xx0x/gbpxl/schematic-bom-pcb/gbpxl-bom.ods

gbpxl v1.0 BOM, github.com/xx0x/gbpxl
ID | Name | Designator | Footprint | Quantity | Manufacturer Part | Manufacturer | Supplier | Supplier Part
1 | TPS5430DDAR | U2 | SOIC-8_L5.0-W4.0-P1.27-LS6.0-BL-EP | 1 | TPS5430DDAR | TEXAS INSTRUMENTS | TME | TPS5430DDAR
2 | B340A | D1 | SMA_L4.3-W2.6-LS5.2-FD | 1 | B340A | MDD | LCSC | C64982
3 | 220u | C5 | CAP-D8XF2.3_CUT | 1 | A750EK227M1AAAE018 | KEMET | TME | A750EK227M1AAAE018
4 | 22uH | L1 | IND-707040 | 1 | CDRH74-220(F) | ML | LCSC | C133406
5 | 10k | R1 | 0805' | 1
6 | 3.24k | R2 | 0805' | 1
7 | 300 | R3 | 0805' | 1
8 | DSUB25 | COM1 | DSUB25_DOUBLE_SIDED | 1 | DB25-SP | ENCITECH | TME | DB25-SP
9 | 470n | C6,C7,C8,C10,C9 | 0805' | 5
10 | 100n | C1 | 0805' | 1
11 | 4.7u | C3,C2 | 0805' | 2
12 | 10n | C4 | 0805' | 1
13 | DIP SWITCH | SW1 | DIP SWITCHEI-04 | 1 | NDI-04H-V | DIPTRONICS | TME | EAH104E
14 | LED-3MM | LED1 | LED-3MM/2.54 | 1 | FYL-3014LRD1A | FORYARD | TME | FYL-3014LRD1A
15 | MAX232ECSE+ | U3 | SOIC-16_L9.9-W3.9-P1.27-LS6.0-BL | 1 | MAX232ECSE+ | Maxim Integrated | TME | MAX232ECSE+
16 | ATMEGA4809 | U1 | TQFP-48_L7.0-W7.0-P0.50-LS9.0-BL | 1 | ATMEGA4809-AFR | MICROCHIP TECHNOLOGY | TME | ATMEGA4809-AFR
17 | CASE |  |  |  | 2360-0102-23 | ENCITECH | TME | CCOV25-SCL-BK
