xx0x/gbpxl/build-instructions/BUILD_INSTRUCTIONS.md

# gbpxl build instructions

The kit contains quite small components, but it's not THAT difficult to solder it. If you haven't soldered SMD stuff before, I would recommend watching some videos how to to that (eg. https://www.youtube.com/watch?v=f9fbqks3BS8). The PCB surface may differ from pictures (HASL/ENIG), based on the current PCB order.

Also, download the [schematic](https://github.com/xx0x/gbpxl/raw/master/schematic-bom-pcb/gbpxl-schematic.pdf) at first.

*Disclaimer: I'm a self-taught hobbyist, not a "professional" so if you have better tools or practices, use them as you wish.*

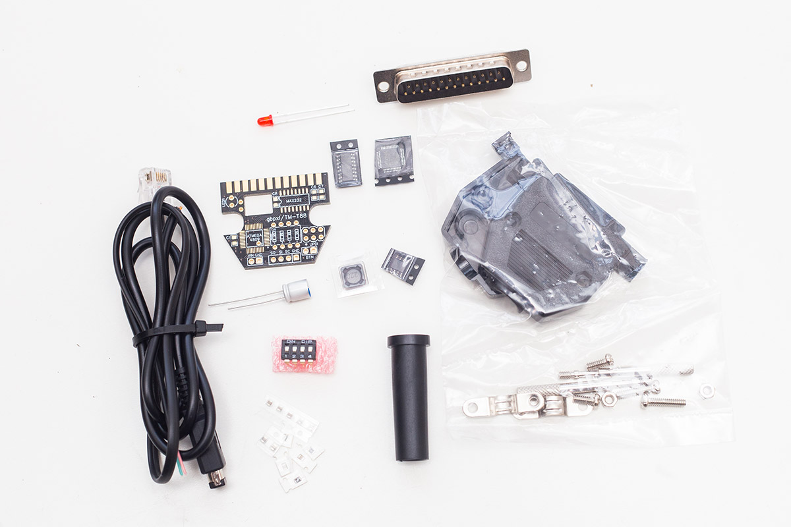
[picture p5: build-instructions/img/gbpxl-build-001.jpg]


## The kit contains

| PCB Designator  | Part name |
|---|---|
| U1 | ATMEGA4809 microcontroller (pre-programmed) |
| U2 | TPS5430DDAR	buck regulator |
| U3 | MAX232 RS232 transceiver |
| R1 | 10k SMD 0805 resistor |
| R2 | 3.24k SMD 0805 resistor	 |
| R3 | 300 SMD 0805 resistor |
| C1 | 100n SMD 0805 capacitor |
| C2,C3 | 4.7u SMD 0805 capacitor |
| C4 | 10n SMD 0805 capacitor |
| C5 | 220u THT capacitor |
| C6,C7,C8,C9,C10 | 470n SMD 0805 capacitors |
| D1 | B340A diode |
| L1 | 22uH power inductor	 |
| SW1 | 4 position DIP SWITCH |
| LED1 | 3mm red LED |
| COM1 | DSUB25 male connector |
| - | Connector case + screws |
| - | RJ12 power cable (approx 20 cm) |
| - | Game Boy link cable (smaller connector type, approx 55 cm) |
| - | Cable strain relief |

The kit contains link cable for newer Game Boys (Pocket, Color), since the cables for the original Game Boy are quite hard to get (= expensive). If you want to use it with the original GB, get yourself an adapter as you can see in the video.

## 1. Step: Soldering the components

First, start with the buck regulator. Tin the large pad and one IC pad.

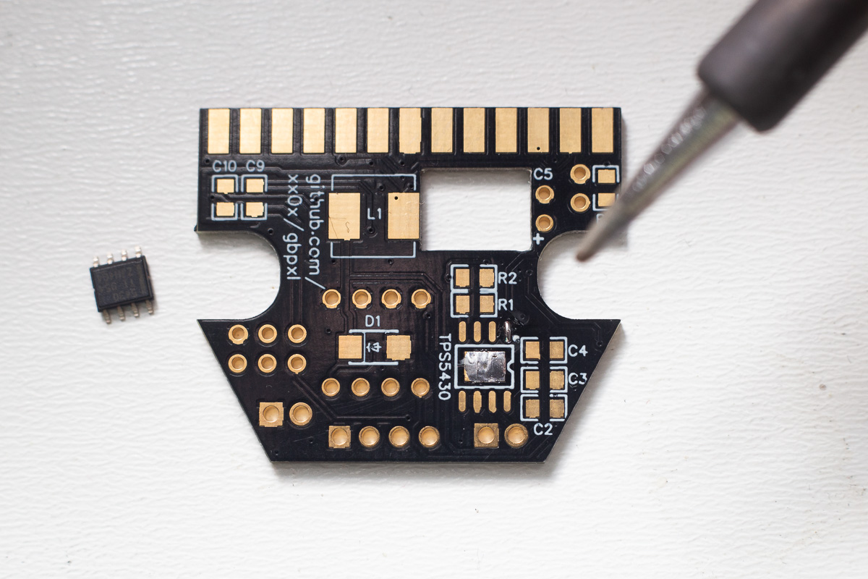
[picture p6: build-instructions/img/gbpxl-build-002.jpg]

  
&nbsp;

Then, solder the first IC pin.

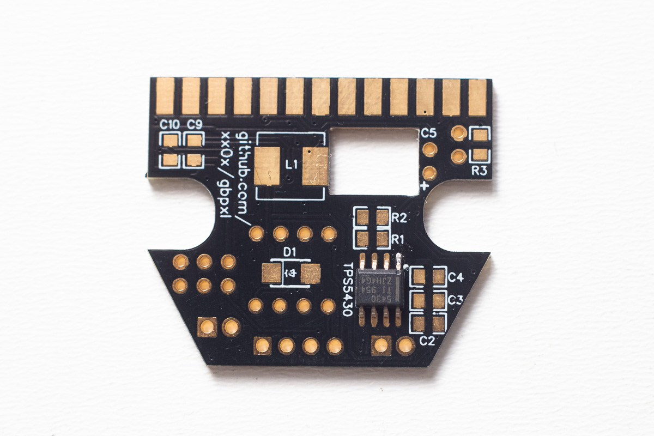
[picture p7: build-instructions/img/gbpxl-build-003.jpg]


&nbsp;

Turn the PCB upside down, and reheat the large pad using the hole to melt the solder under the chip - while putting a little bit of pressure on the board for the IC to make good contact.

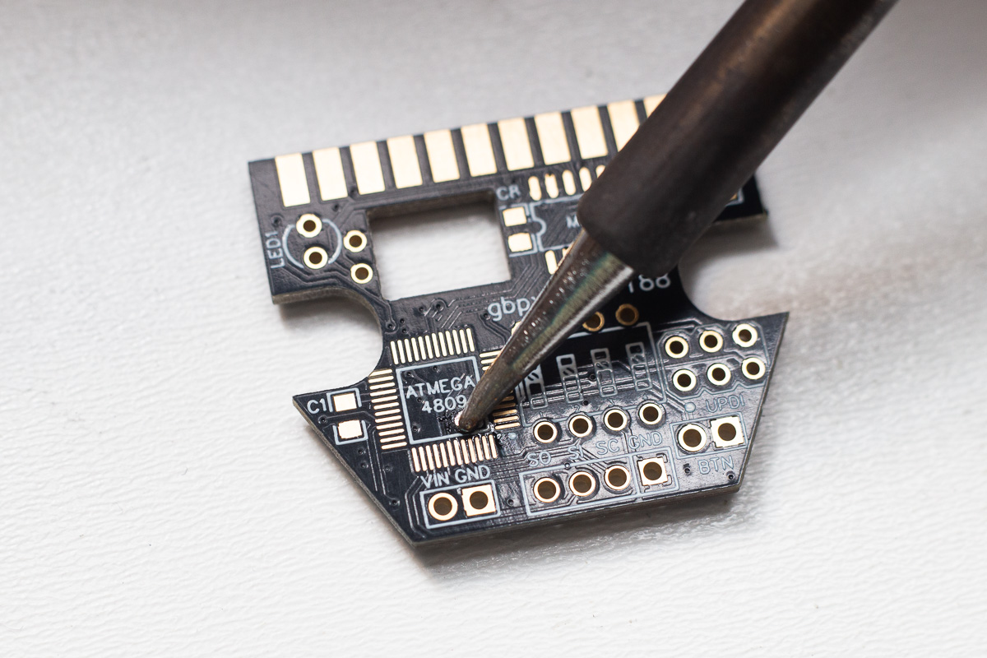
[picture p8: build-instructions/img/gbpxl-build-004.jpg]


&nbsp;

Finish soldering the buck regulator, and remember, FLUX is your best friend!

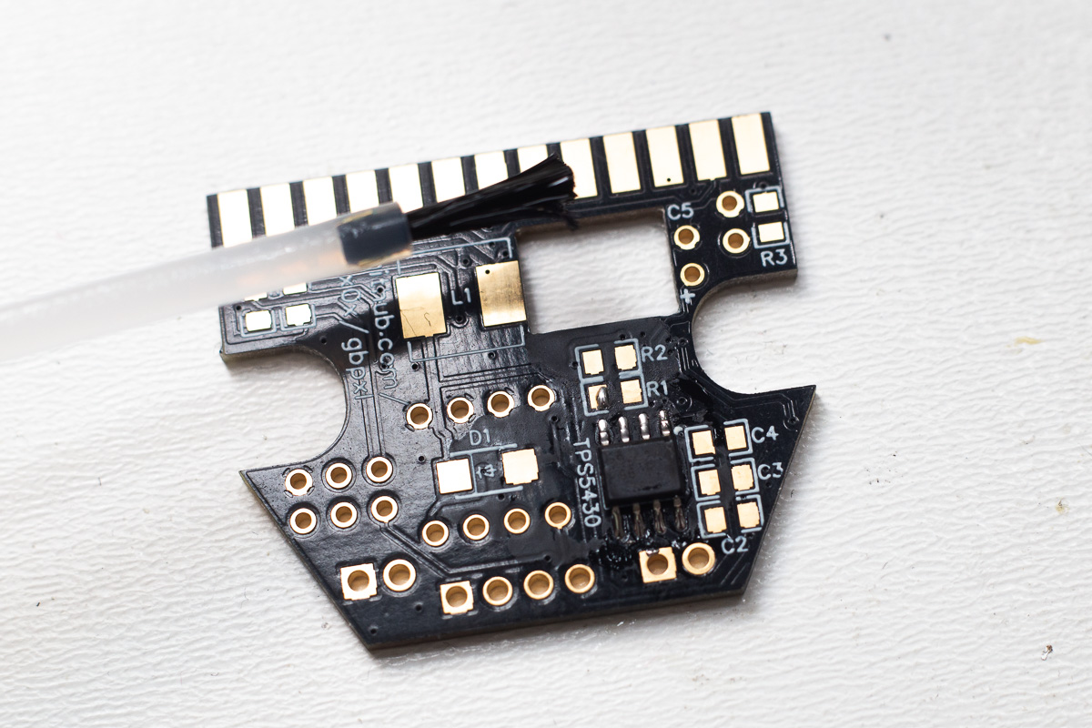
[picture p9: build-instructions/img/gbpxl-build-005.jpg]


&nbsp;

Tin one or two pads for the ATmega. Then, while reheating the pad, push the MCU into it with your tweezers.

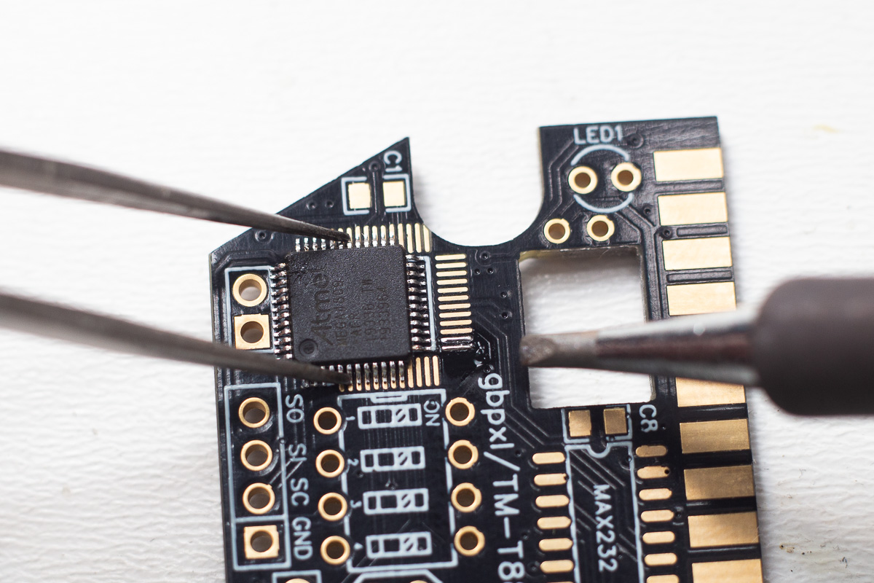
[picture p10: build-instructions/img/gbpxl-build-006.jpg]


&nbsp;

Solder the oposite legs.

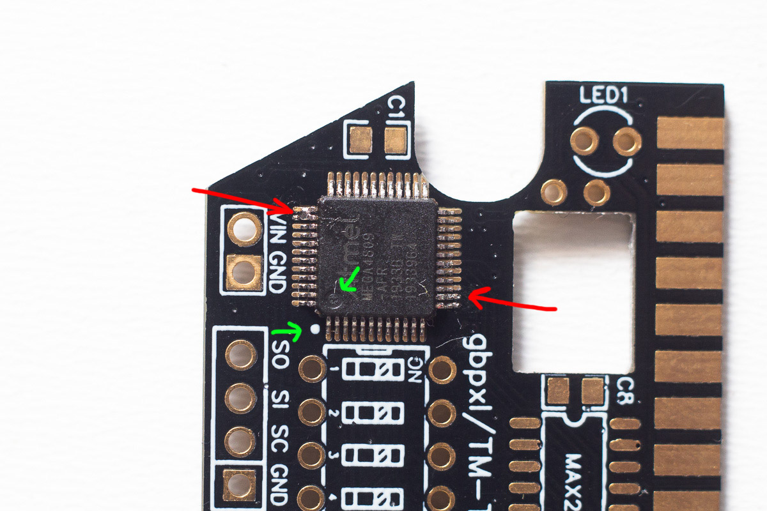
[picture p11: build-instructions/img/gbpxl-build-007.jpg]


&nbsp;

Then, make sure everything's how it's supposed to be and solder the rest. If you end up with solder bridges, you can use solder wick for sucking the excess solder.

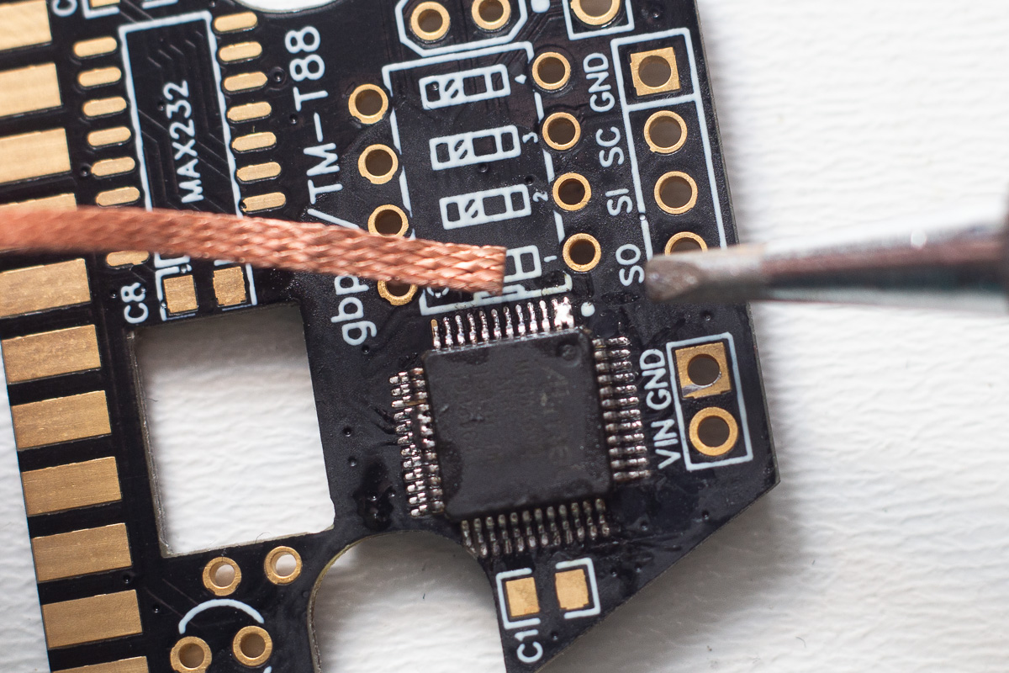
[picture p12: build-instructions/img/gbpxl-build-008.jpg]


&nbsp;

You should end up with something like this.

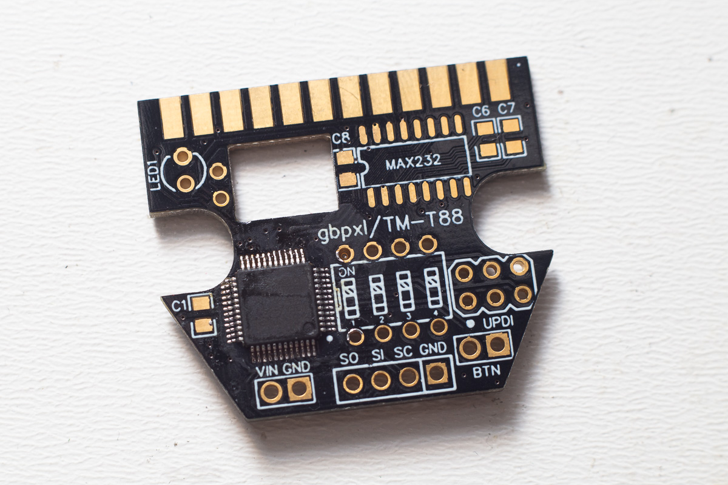
[picture p13: build-instructions/img/gbpxl-build-009.jpg]


&nbsp;

Next, solder the 0805 capacitors and resistors. Resistors are easier, since they have their value written on them. I've manually marked 10nF and 100nF capacitors since they look almost identical and there is one piece of each.

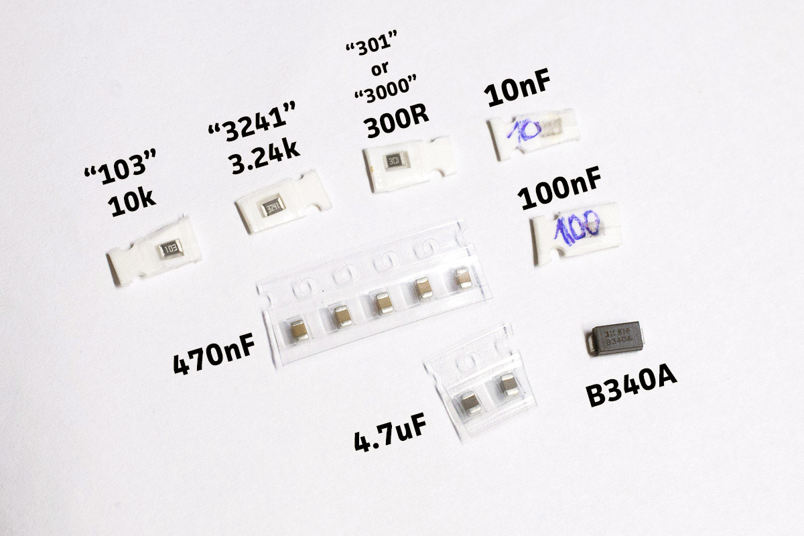
[picture p14: build-instructions/img/gbpxl-build-010.jpg]


&nbsp;

You can use exacto knife for separating the protective layer.

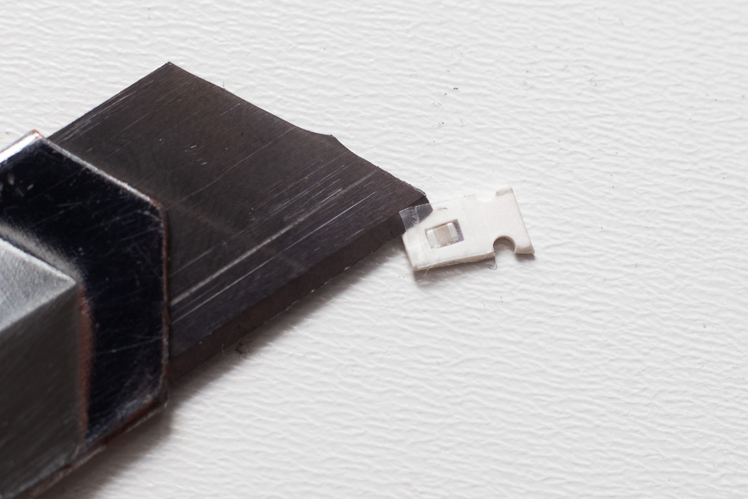
[picture p15: build-instructions/img/gbpxl-build-011.jpg]


&nbsp;

Again, tin one pad and then drag the component into the solder while reheating it. The polarity isn't important when soldering this capacitor.

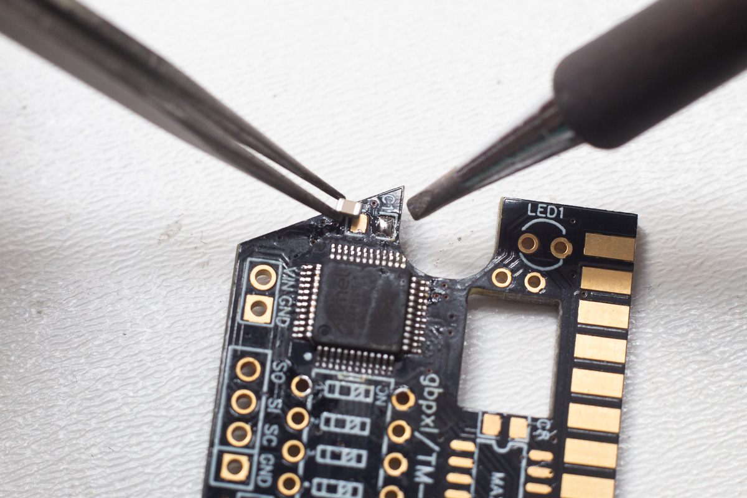
[picture p16: build-instructions/img/gbpxl-build-012.jpg]


&nbsp;

Then, solder the opposite side.

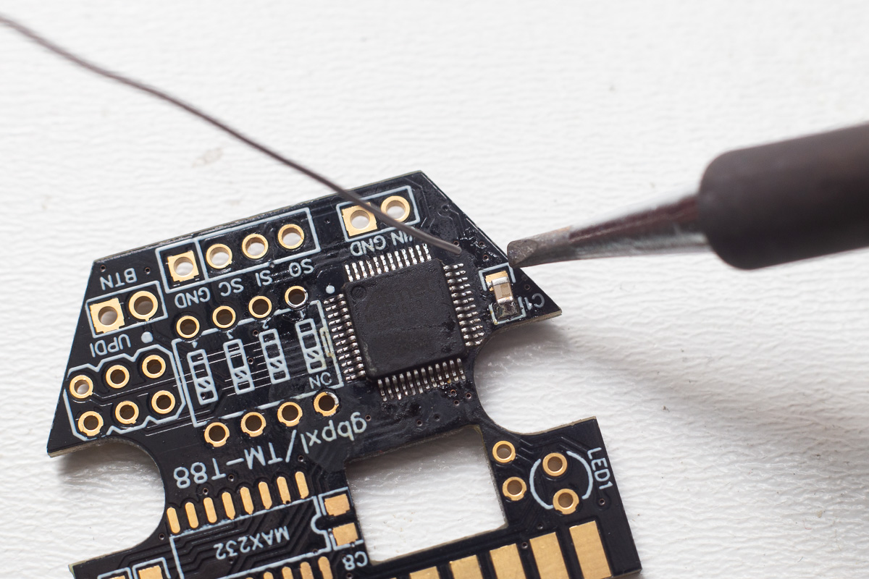
[picture p17: build-instructions/img/gbpxl-build-013.jpg]


&nbsp;

I usually pre-tin pads for all components at once.

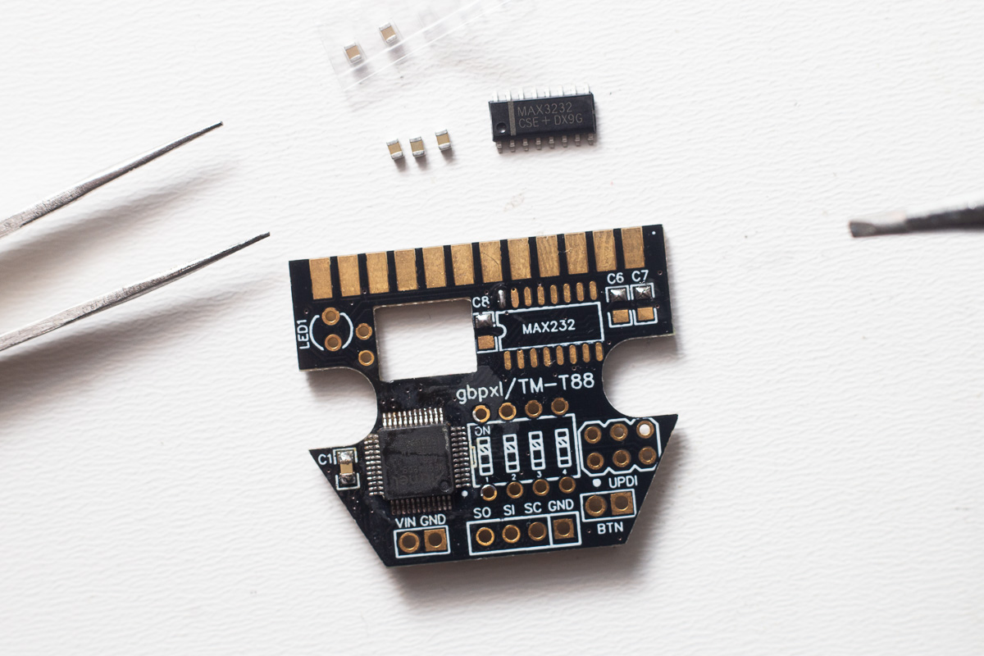
[picture p18: build-instructions/img/gbpxl-build-014.jpg]


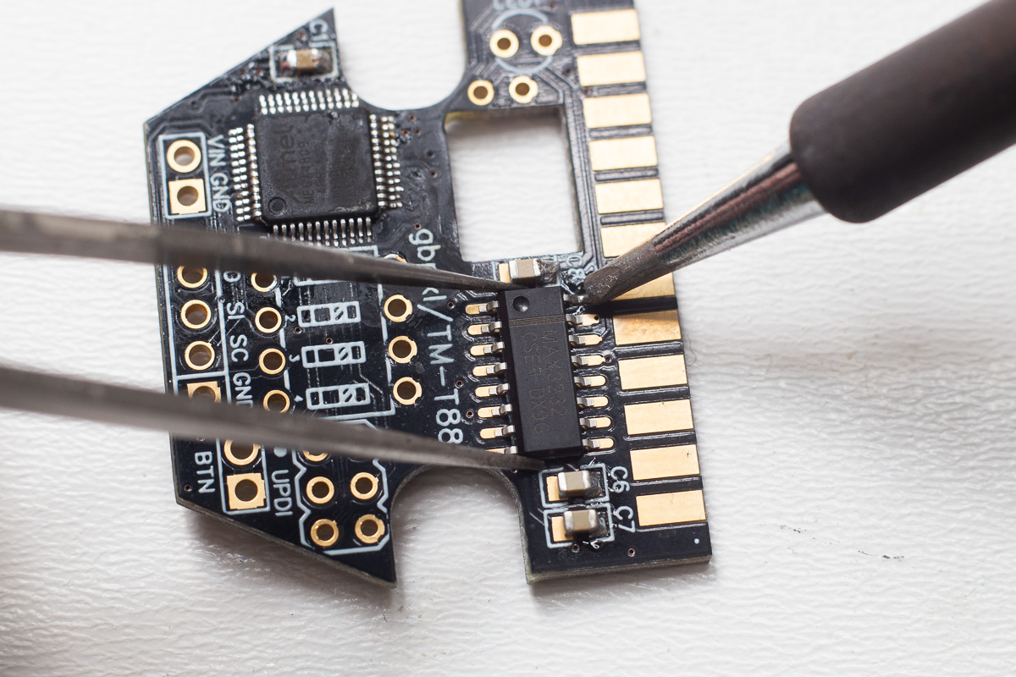
[picture p19: build-instructions/img/gbpxl-build-015.jpg]


&nbsp;

The result should look like this.

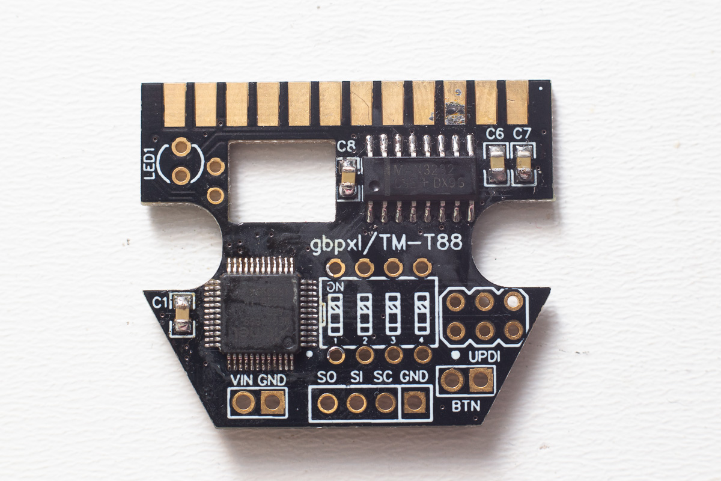
[picture p20: build-instructions/img/gbpxl-build-016.jpg]


&nbsp;

Now let's continue with the bottom side. Watch out - the diode is polarized (the strip on the diode must match the strip on the PCB).

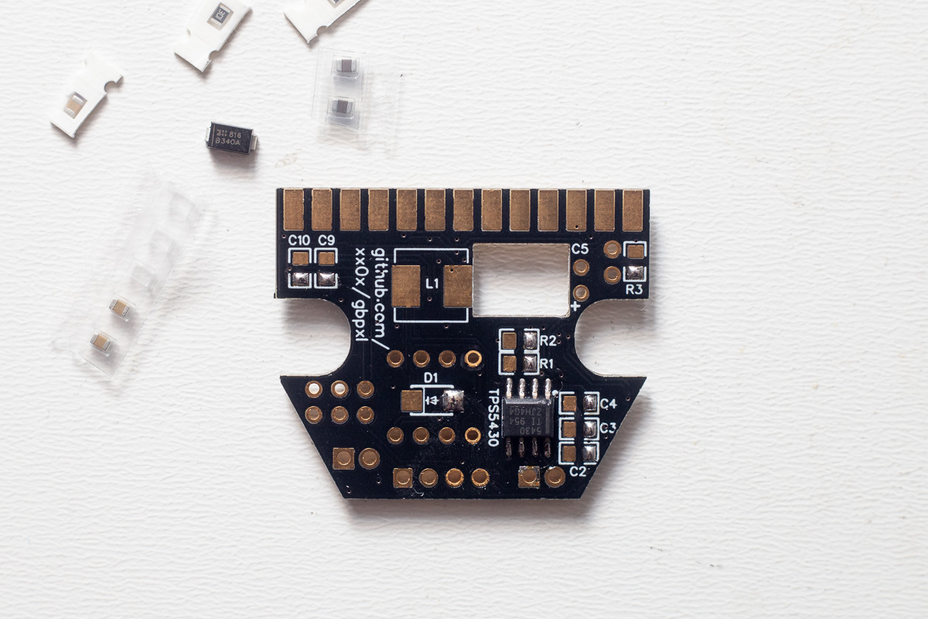
[picture p21: build-instructions/img/gbpxl-build-017.jpg]


&nbsp;

Then, prepare the pads for the inductor. I usually tin both pads, one with more solder.

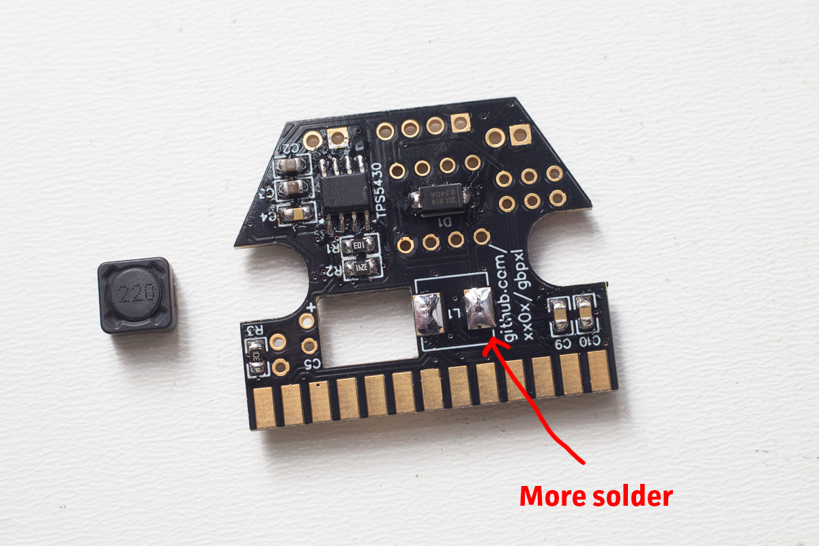
[picture p22: build-instructions/img/gbpxl-build-018.jpg]


&nbsp;

Then drag the inductor into the solder while reheating the pad with more solder.

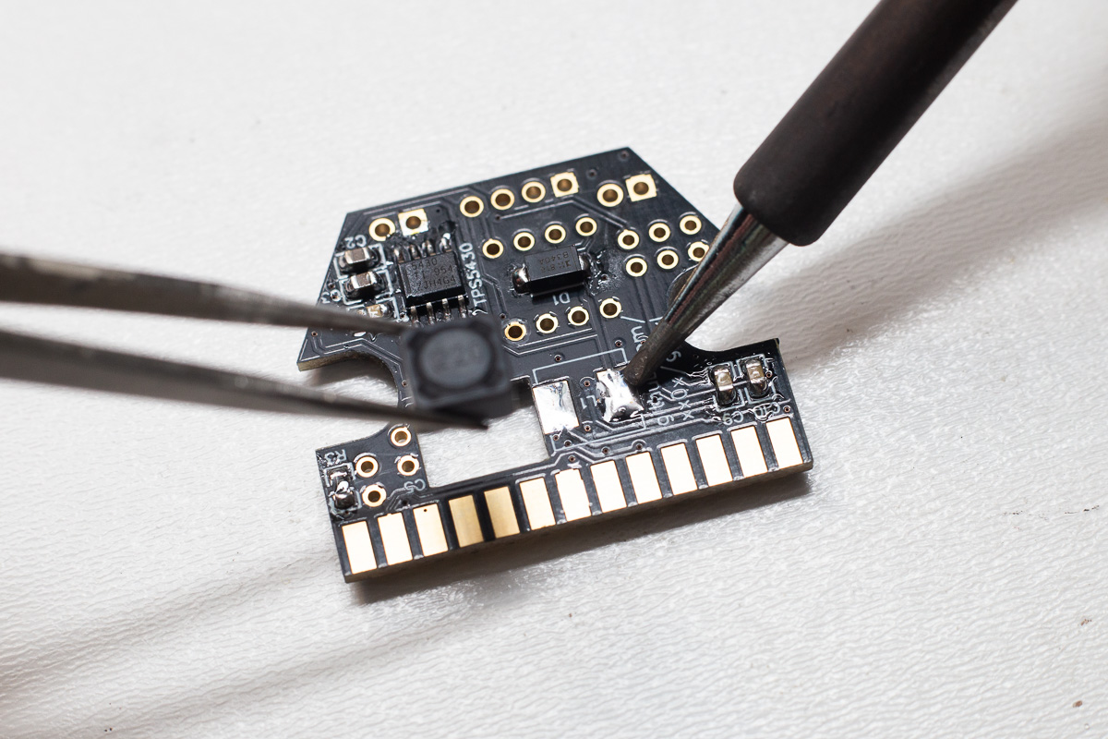
[picture p23: build-instructions/img/gbpxl-build-019.jpg]


&nbsp;

Then finish it by reheating the other pad from the side - adding little bit of solder helps!

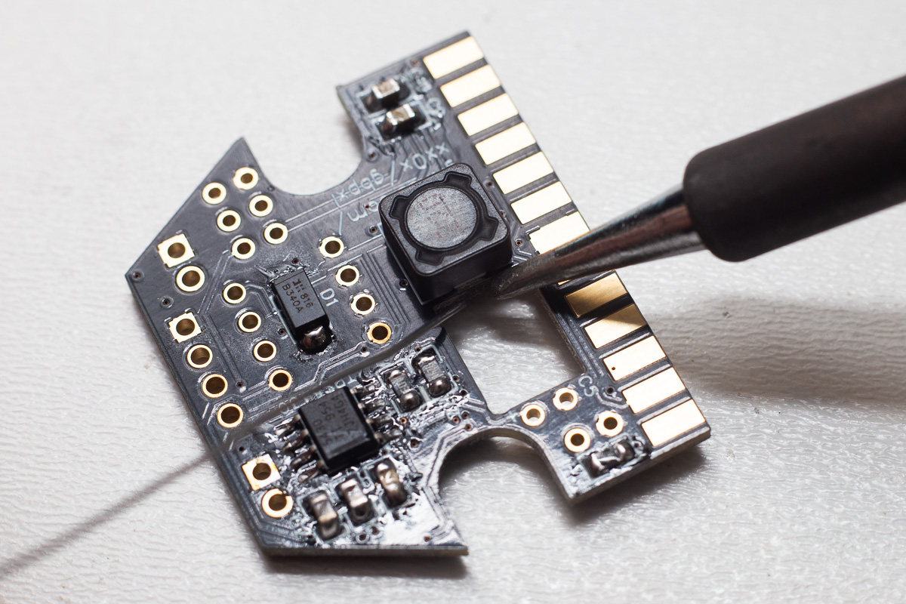
[picture p24: build-instructions/img/gbpxl-build-020.jpg]


&nbsp;

Next comes the big capacitor - which has to be mounted sideways because of the clearance. The longer leg is the positive contact.

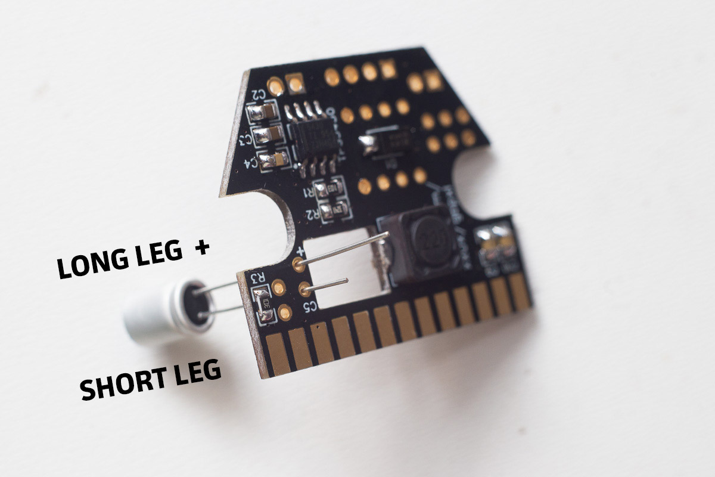
[picture p25: build-instructions/img/gbpxl-build-021.jpg]


&nbsp;

Bend the capacitor inside the PCB hole and solder it.

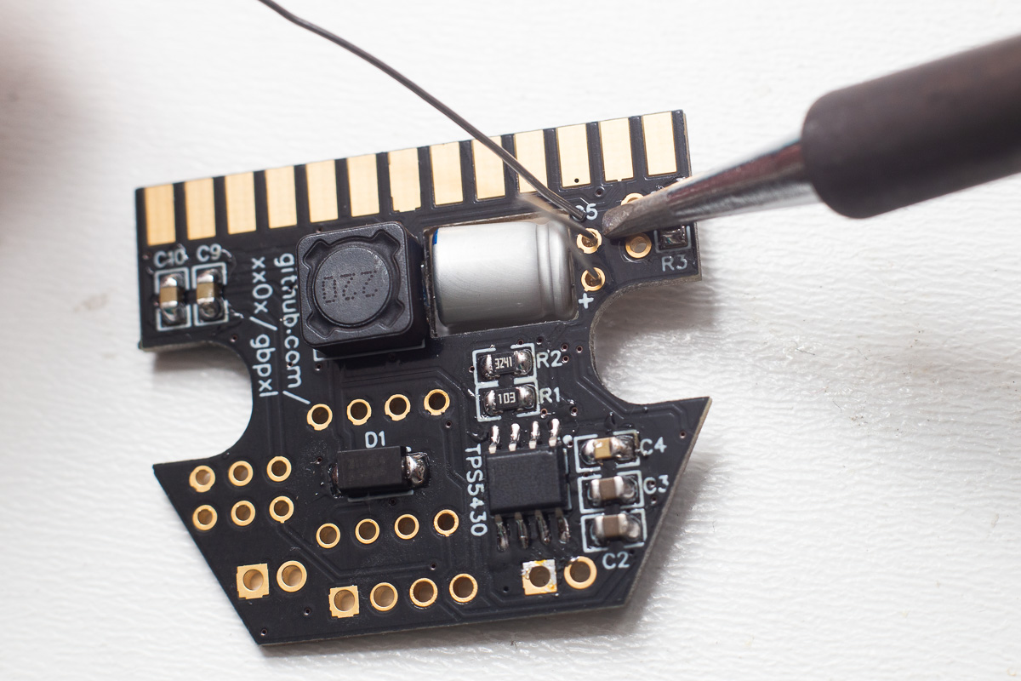
[picture p26: build-instructions/img/gbpxl-build-022.jpg]


&nbsp;

Then, cut the legs.

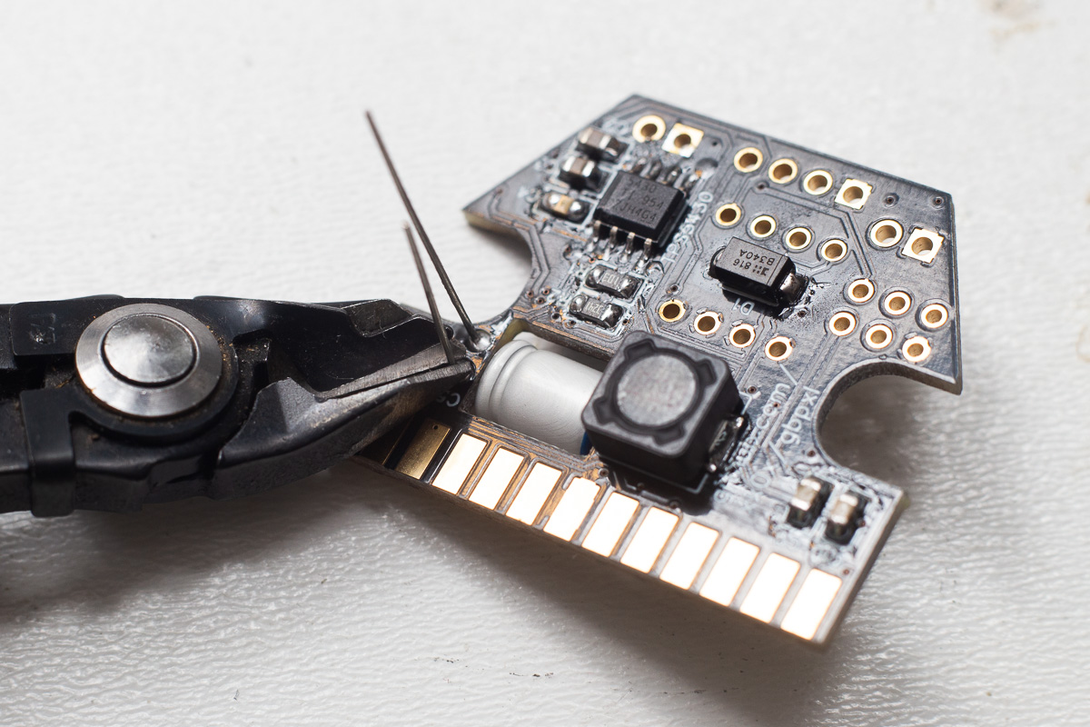
[picture p27: build-instructions/img/gbpxl-build-023.jpg]


&nbsp;

Solder the 3mm diode, the short leg goes to the flat side (closer to the RS232 connector).

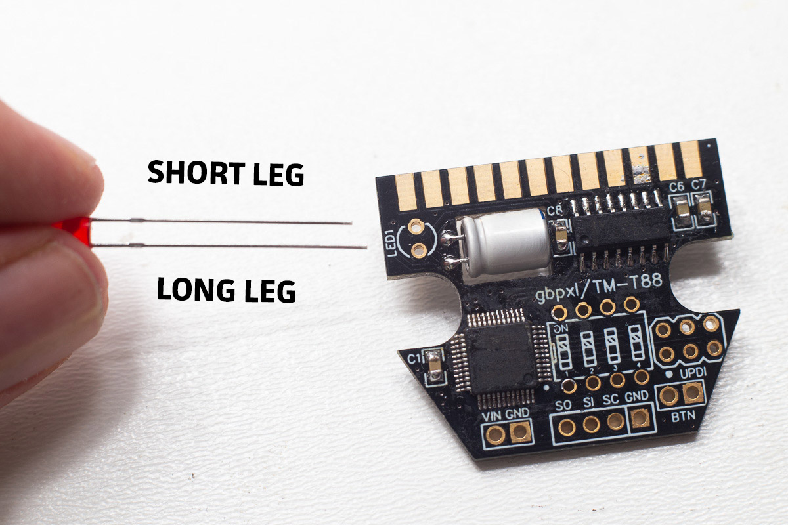
[picture p28: build-instructions/img/gbpxl-build-024.jpg]


&nbsp;

Now, *almost complete*! :-)

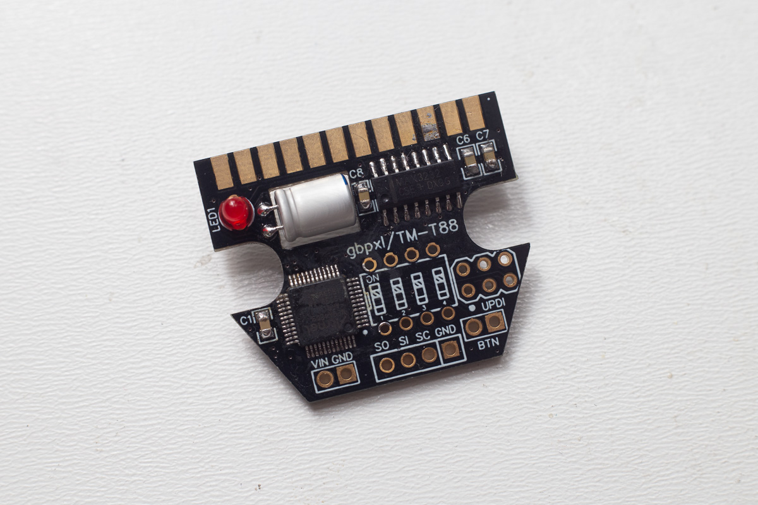
[picture p29: build-instructions/img/gbpxl-build-025.jpg]


## 2. Step: Adjusting the case

Cut the unnecessary plastic supports, use flush cutters or a dremel tool. It doesn't have to look perfect, since it will be hidden inside. Just don't break the outside of the case.

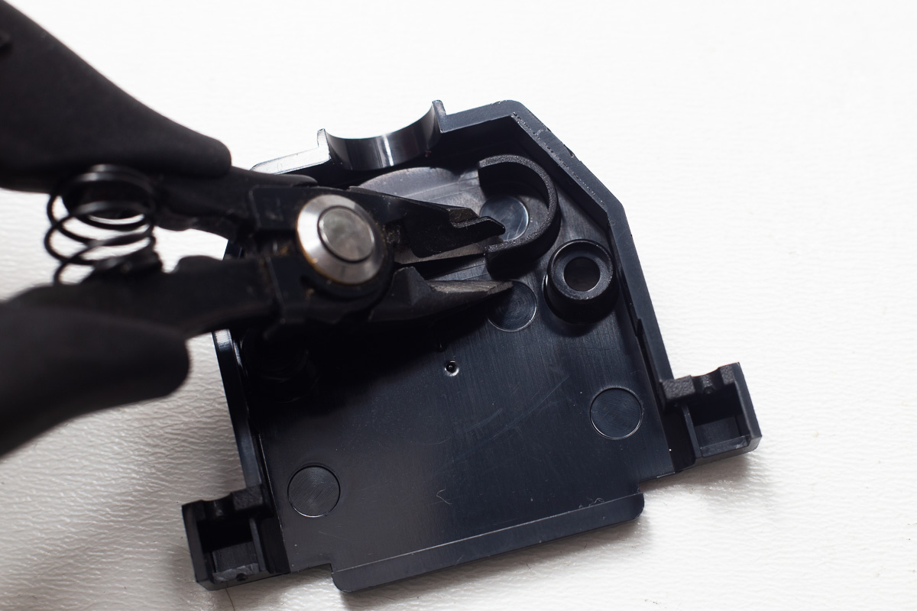
[picture p30: build-instructions/img/gbpxl-build-026.jpg]

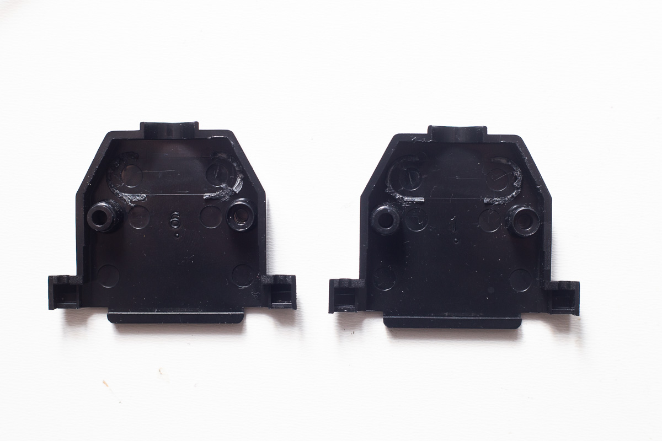
[picture p31: build-instructions/img/gbpxl-build-027.jpg]


## 3. Step: Soldering the RS232 connector

Position the connector and PCB into the case. Support the PCB with something (eg. your tweezers) on the side opposite the connector and try to align everything as best as possible.

**Solder only two contacts!**

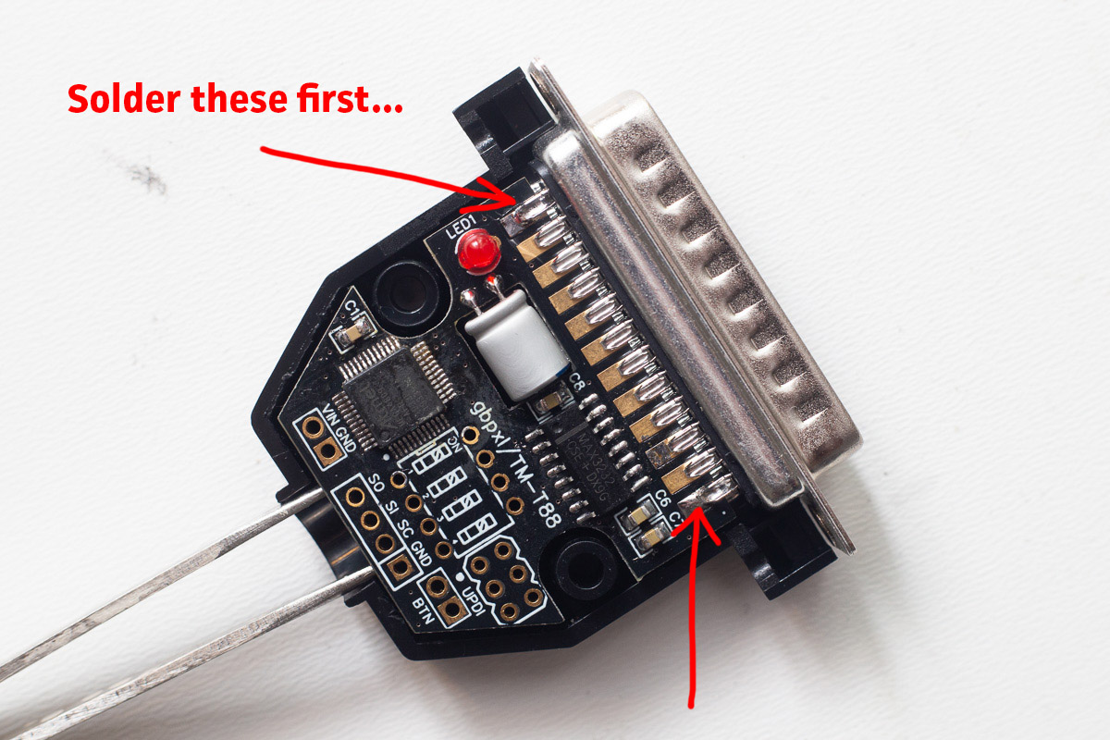
[picture p32: build-instructions/img/gbpxl-build-028.jpg]


&nbsp;

Then, take out the PCB and solder one contact on the opposite side.

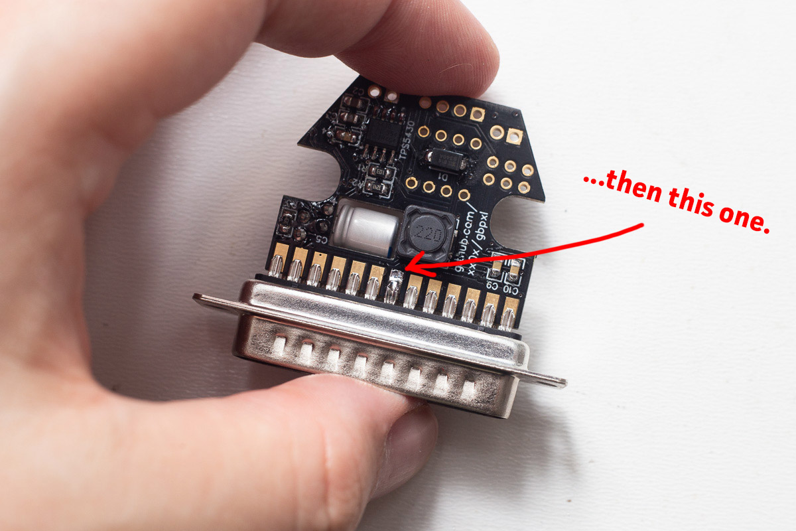
[picture p33: build-instructions/img/gbpxl-build-029.jpg]


&nbsp;

Make sure everything's straight and that it fits inside the connector case. Since **the last thing you want to do is having to de-solder the connector** because it doesn't fit inside.

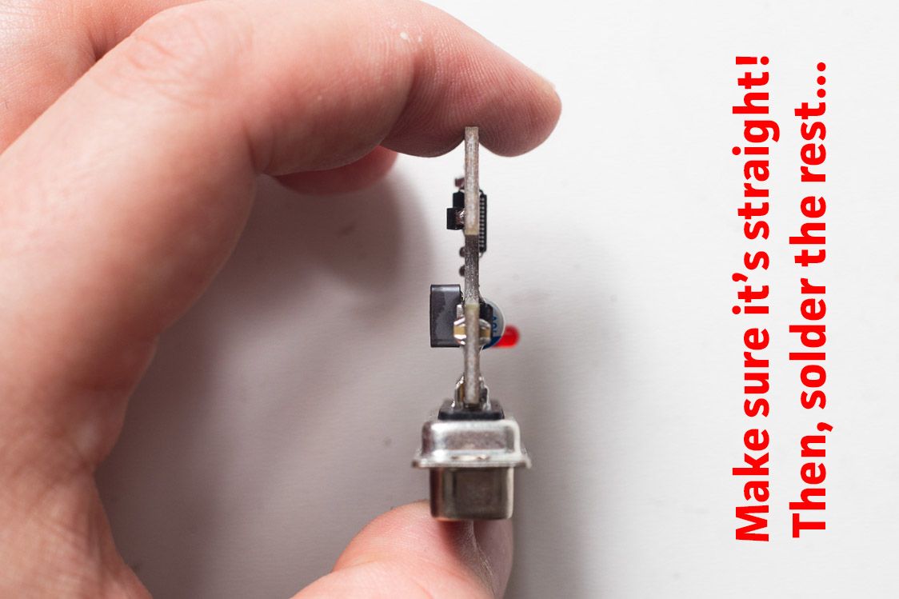
[picture p34: build-instructions/img/gbpxl-build-030.jpg]


&nbsp;

If everything fits, solder the rest of pins on both sides. Use a lot of solder to make the connection strong!

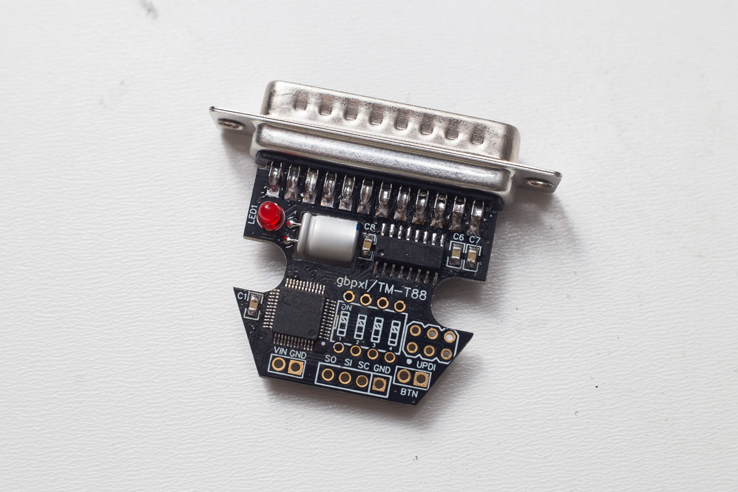
[picture p35: build-instructions/img/gbpxl-build-031.jpg]


## 4. Step: Cleaning

Next, use some rubbing alcohol for cleaning the flux remainings. I like to clean the PCB now, since it's much easier without the DIP switch.

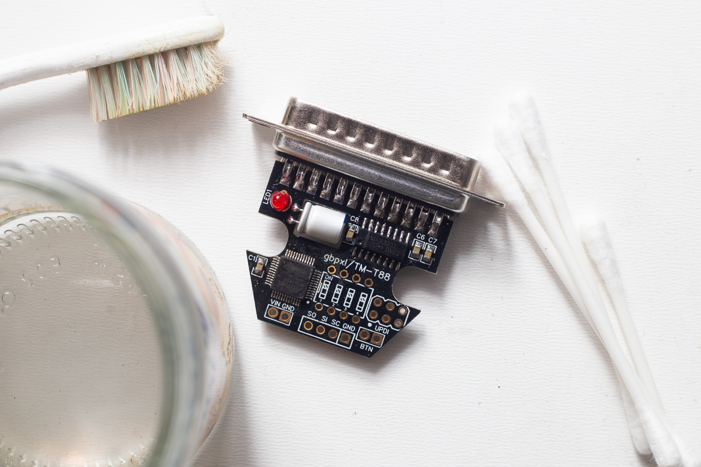
[picture p36: build-instructions/img/gbpxl-build-032.jpg]


&nbsp;

**Much better!**

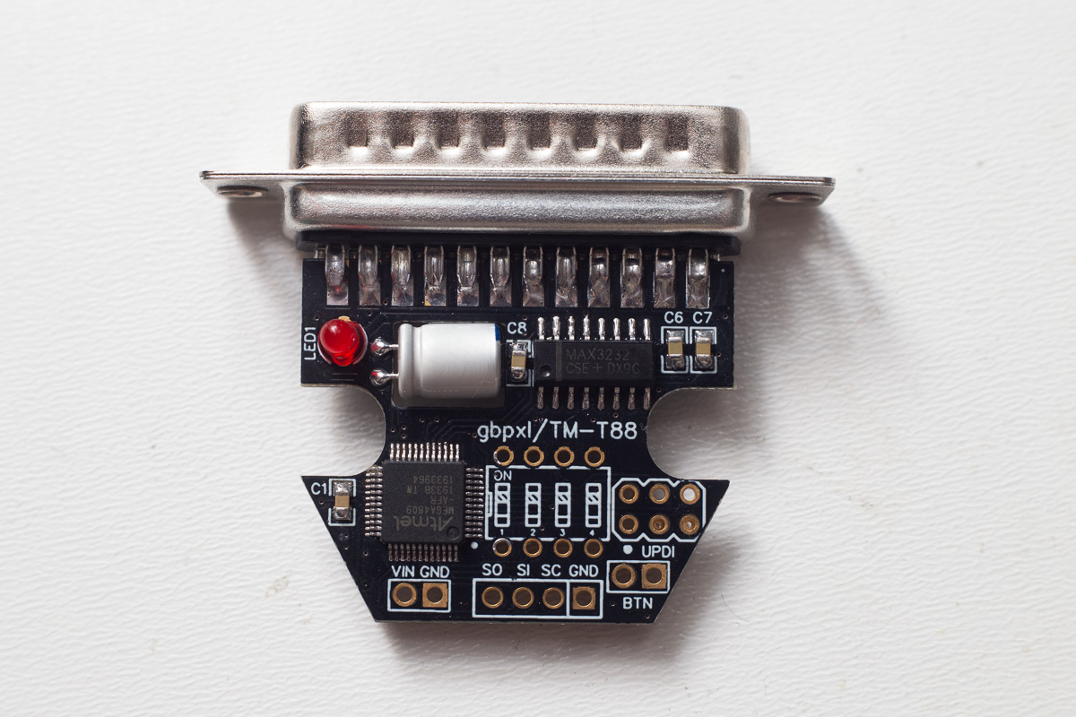
[picture p37: build-instructions/img/gbpxl-build-033.jpg]


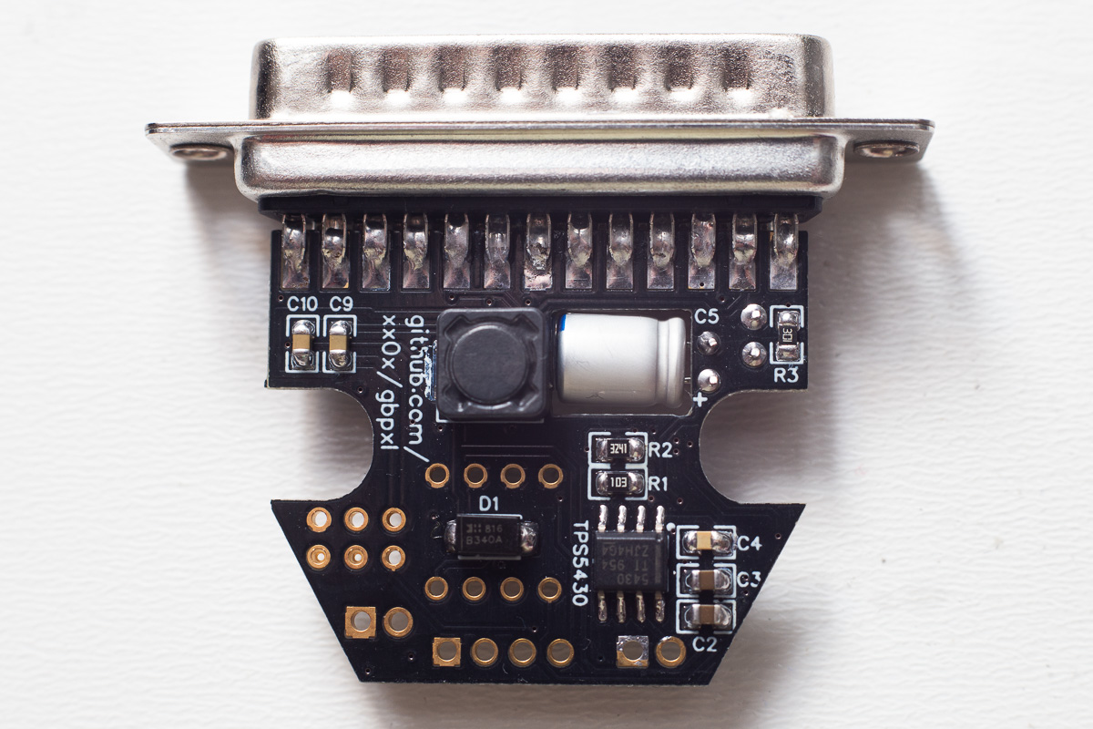
[picture p38: build-instructions/img/gbpxl-build-034.jpg]


## 5. Step: DIP Switch soldering

Solder the two opposite pins while holding the DIP switch inside. 

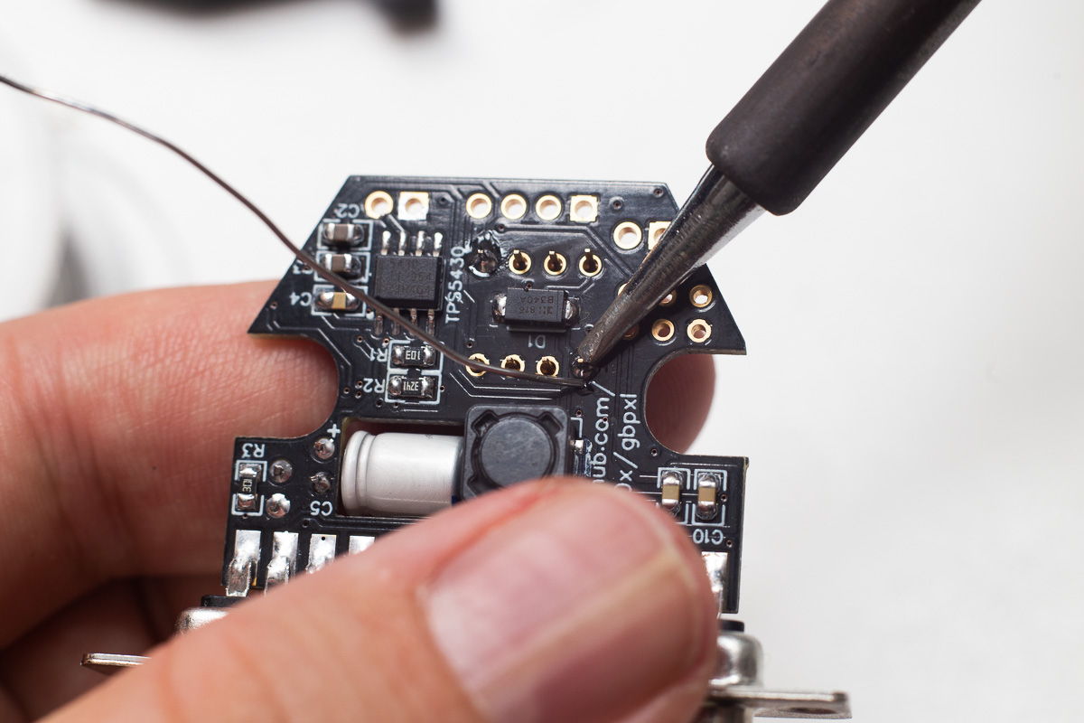
[picture p39: build-instructions/img/gbpxl-build-035.jpg]


&nbsp;

If everything's OK and flat, solder the remaining pins.

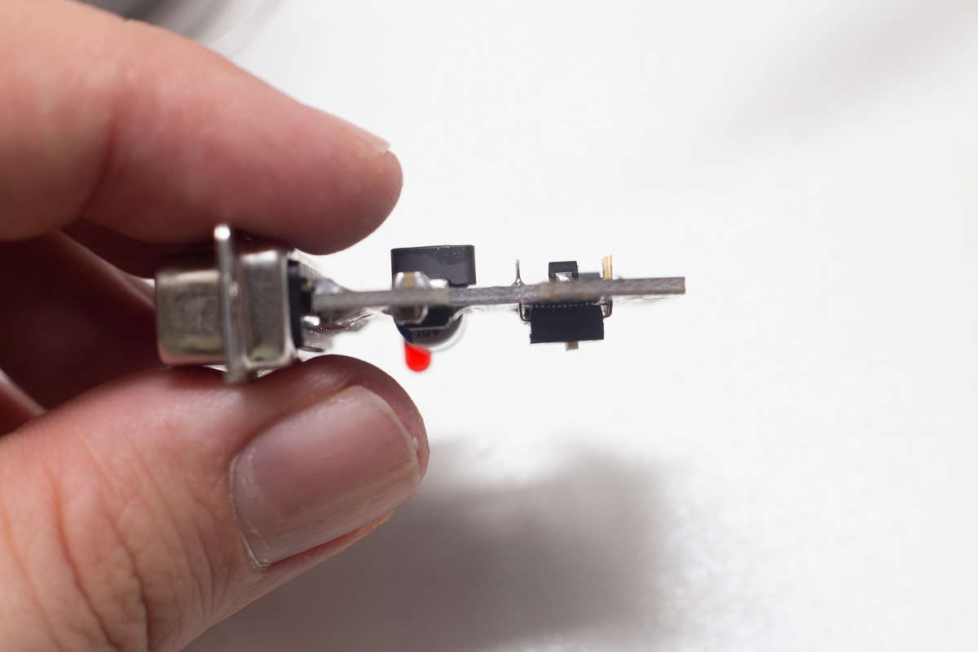
[picture p40: build-instructions/img/gbpxl-build-036.jpg]


&nbsp;

**Almost there!**

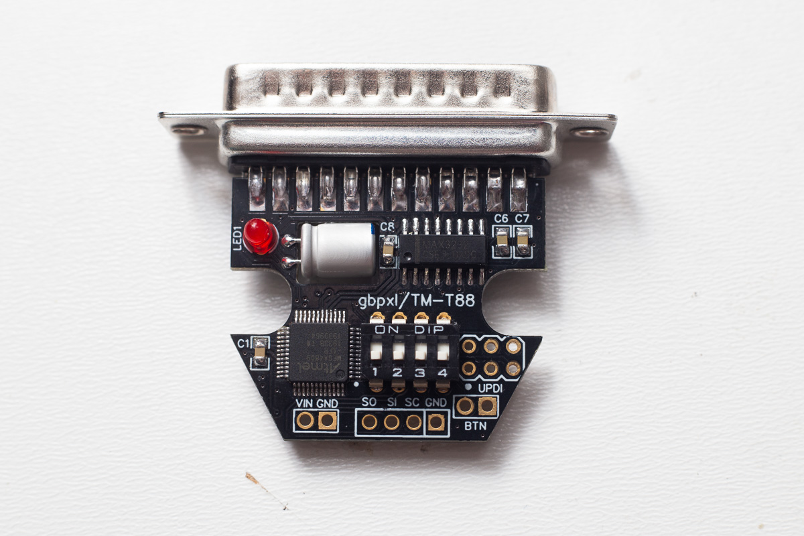
[picture p41: build-instructions/img/gbpxl-build-037.jpg]


## 6. Step: Cable relief adjustments

The cable relief is kind of long by default - it's not neccessary, but it's better to shorten it to approx 2.5cm.

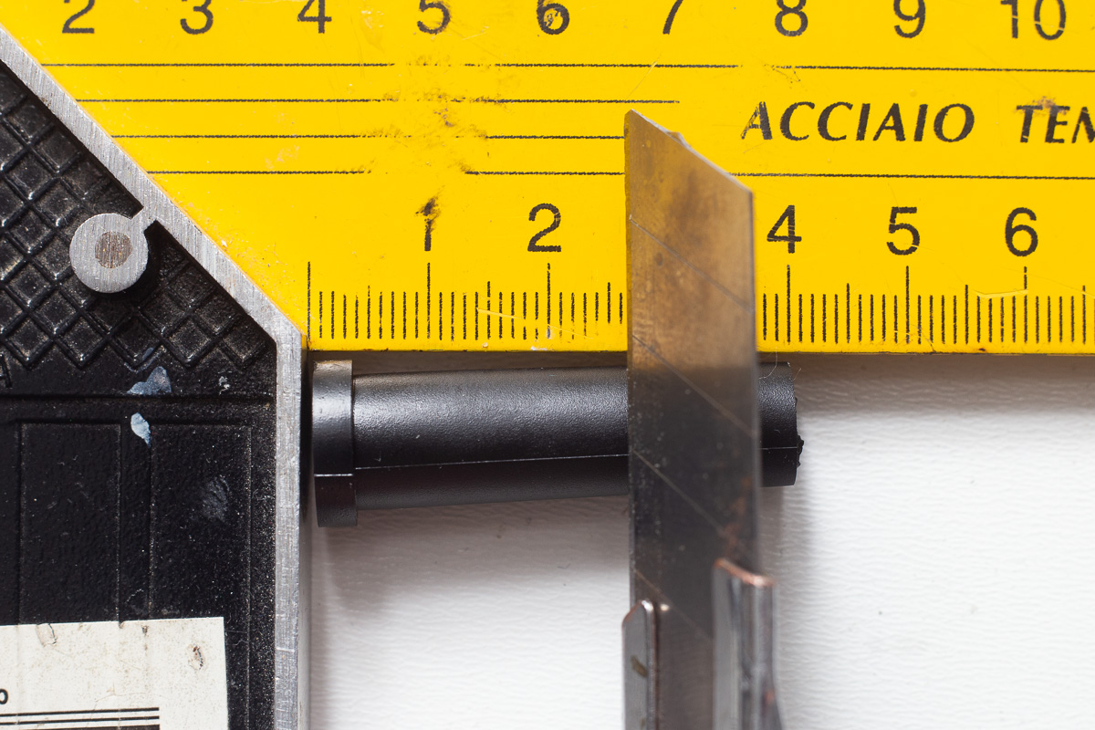
[picture p42: build-instructions/img/gbpxl-build-038.jpg]


&nbsp;

Next, cut 2 small notches for the PCB (approx 2mm wide).

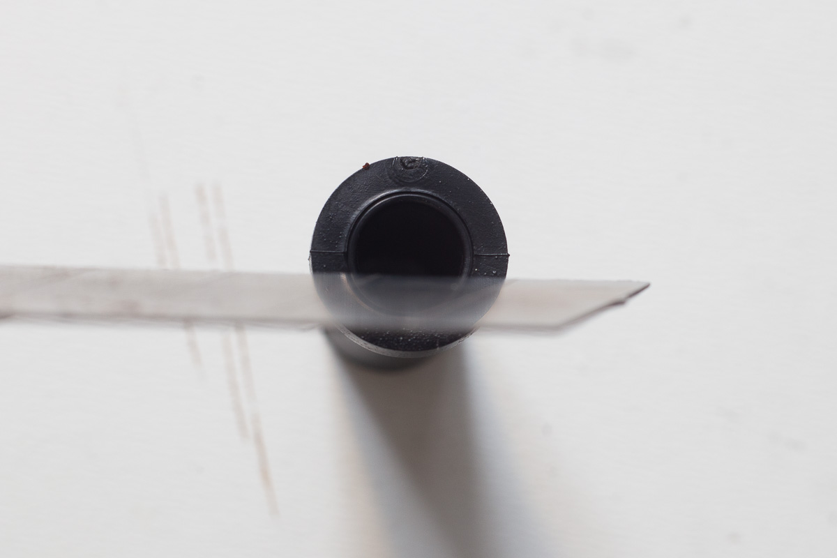
[picture p43: build-instructions/img/gbpxl-build-039.jpg]

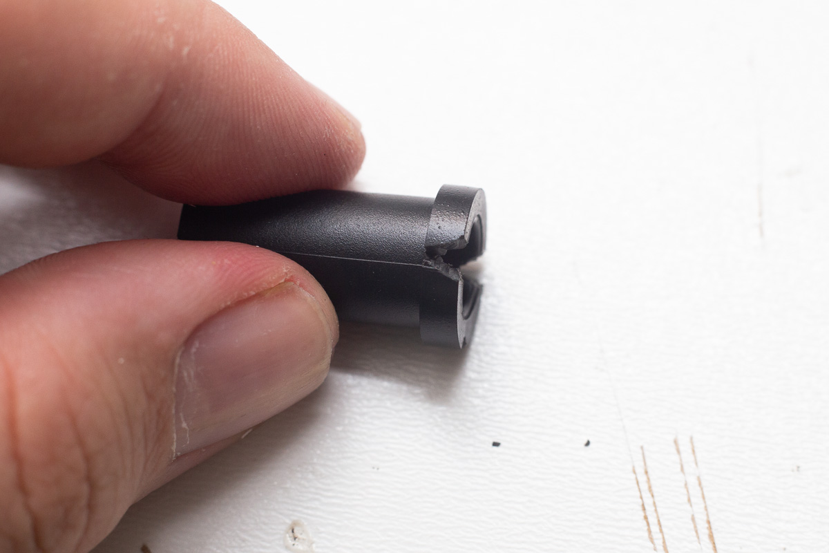
[picture p44: build-instructions/img/gbpxl-build-040.jpg]


&nbsp;

Everything should fit nicely.

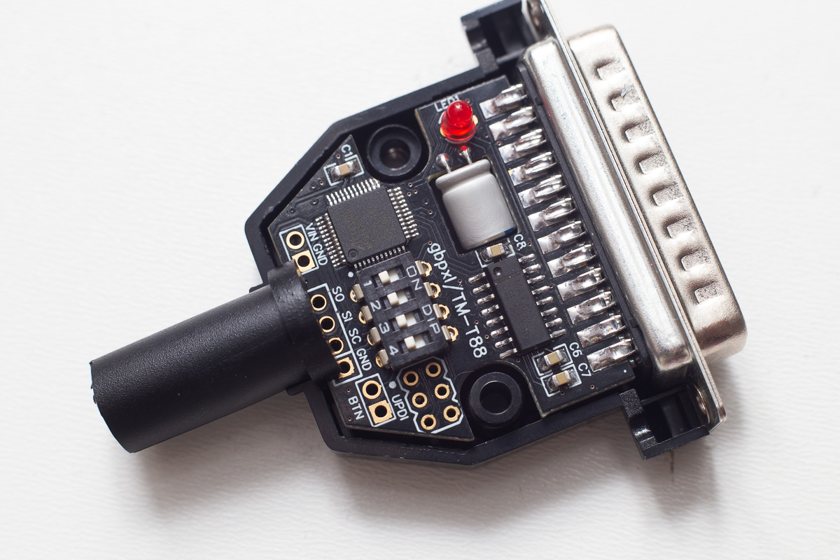
[picture p45: build-instructions/img/gbpxl-build-041.jpg]


## 7. Step: Cables

First, prepare the link cable. Strip it and cut the unnecessary cables. You will only need BROWN/GREEN (SO), GREEN/BROWN (SI), BLUE (SC), RED (GND) cables. Pre-tin them.

SO/SI are serial output/input lines and inside each cable they are swapped. Since the cable you get with the gbpxl kit was originally split in half, you must use your multimeter or try both variants, if the transfer doesn't work. The colors may differ, check the pinout for the reference.

```
  ___________
 |  6  4  2  |                
  \_5__3__1_/     
                            
2. SO (serial output)       |  BROWN / GREEN
3. SI (serial input)        |  GREEN / BROWN
5. SC (serial clock)        |  BLUE
6. GND                      |  RED
```

**Don't forget to pull the cable through the cable relief!**

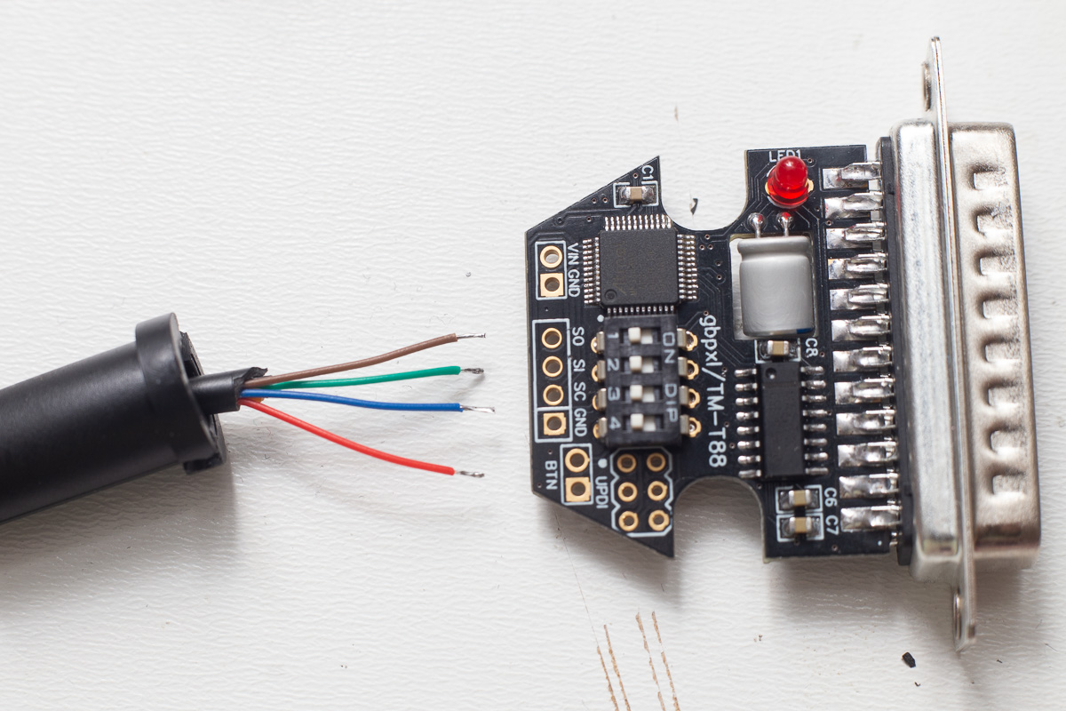
[picture p46: build-instructions/img/gbpxl-build-042.jpg]


&nbsp;

Solder the connections.

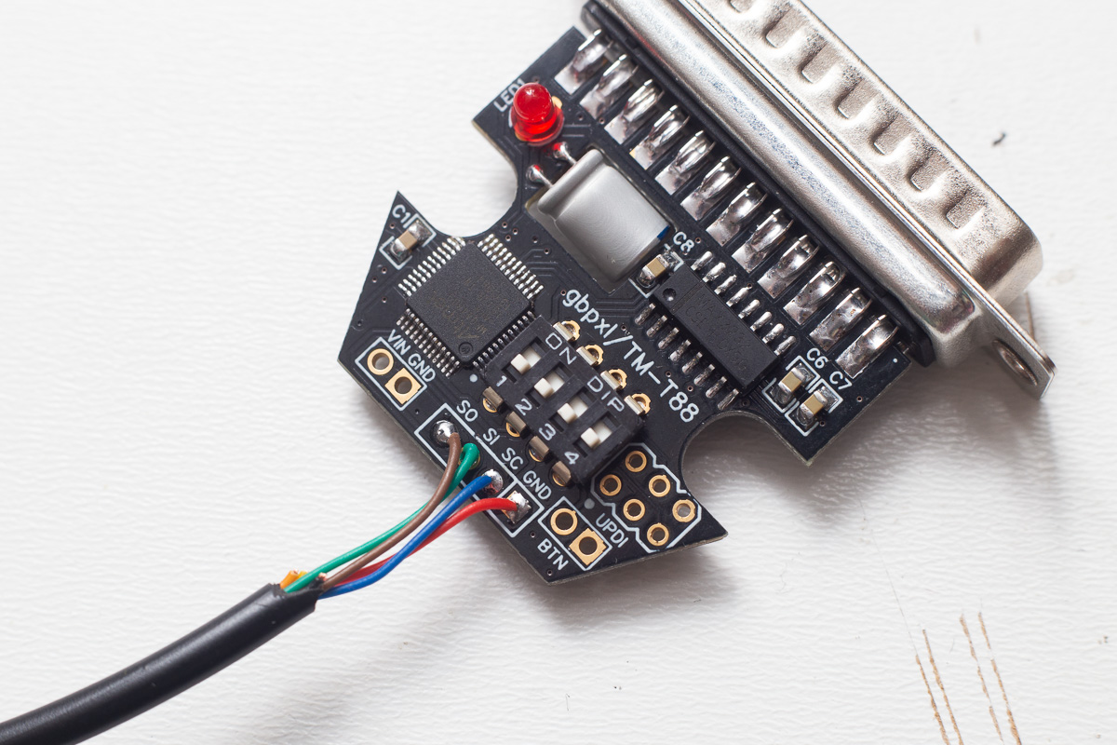
[picture p47: build-instructions/img/gbpxl-build-043.jpg]


&nbsp;

Next, solder the power cable in the similar way. RED (VIN), GREEN (GND).

**Don't forget to pull the cable through the cable relief before soldering!**

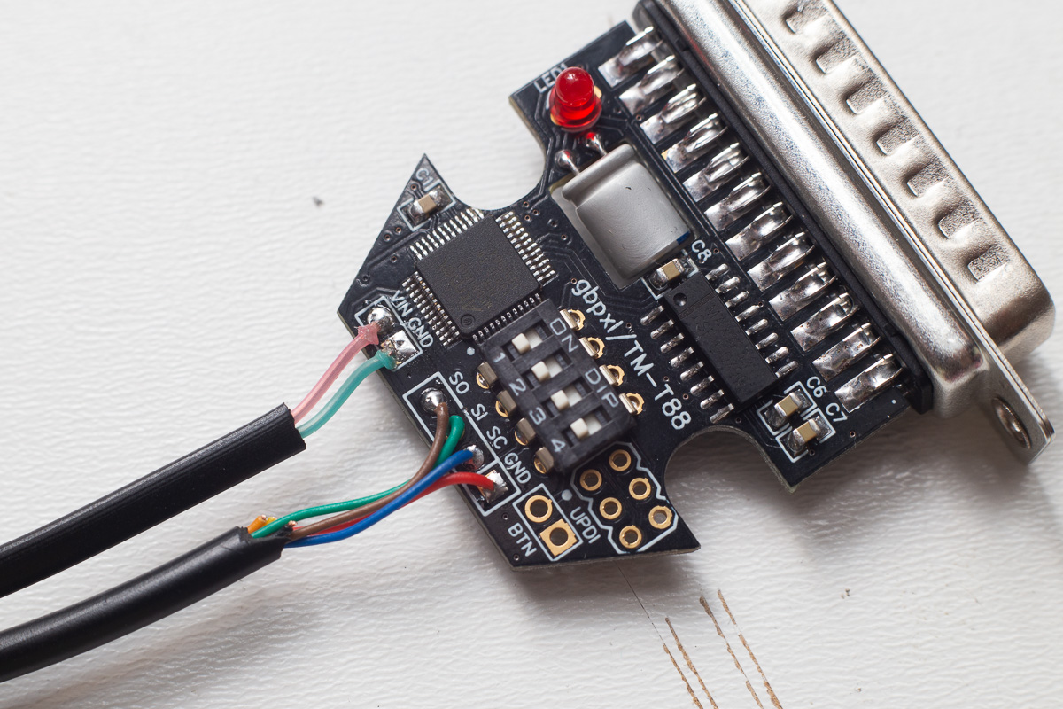
[picture p48: build-instructions/img/gbpxl-build-044.jpg]


## 8. Step: First test

Plug the gbpxl into the printer, connect the power cable and power the printer on. The red LED should light on within fraction of second - that means the device is ready. **If the LED doesn't turn on, immediately unplug the device and check all the solder connections for possible solder bridges etc.**

If everything's fine, set the DIP switches according to your printer (baud rate, method).

I know that my printer is set to 38400 baud rate, that's why the 3rd switch is ON. If you are not sure, try to turn all switches off.

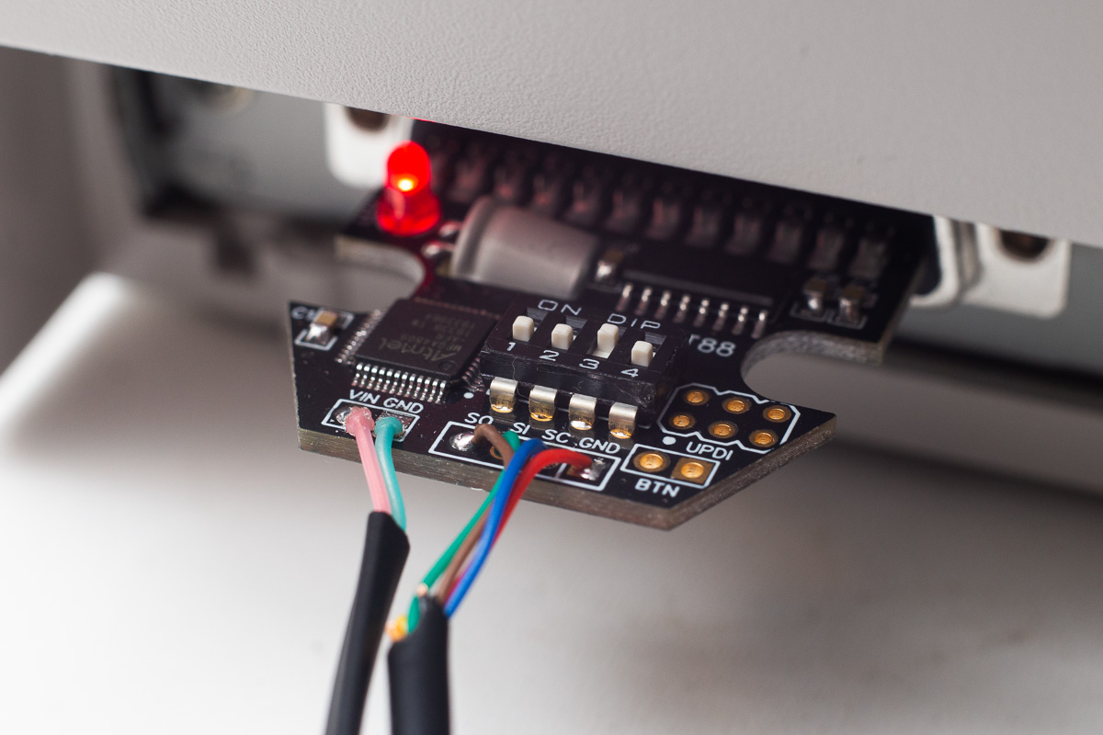
[picture p49: build-instructions/img/gbpxl-build-045.jpg]


&nbsp;

Then, when device is running, short the two pads called BTN. That should print a test image stored in the buffer when the device turns on.

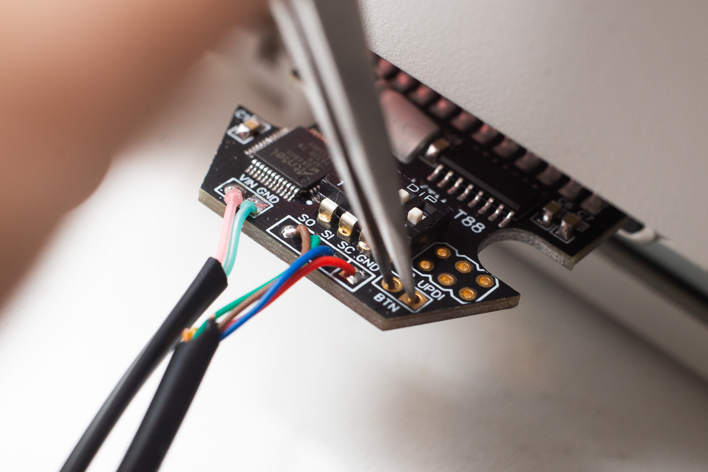
[picture p50: build-instructions/img/gbpxl-build-046.jpg]


&nbsp;

The printer should start printing and the result should look like this. (That's me, lol).

This was printed with 2x scaling and ESC * method. But since my printer is 80 mm type and supports *modern* printing method with less banding, I changed the settings to 3x scaling and GS ( L method by turning switches 1 and 4 to ON position. You will find all the combinations in the README here on GitHub.

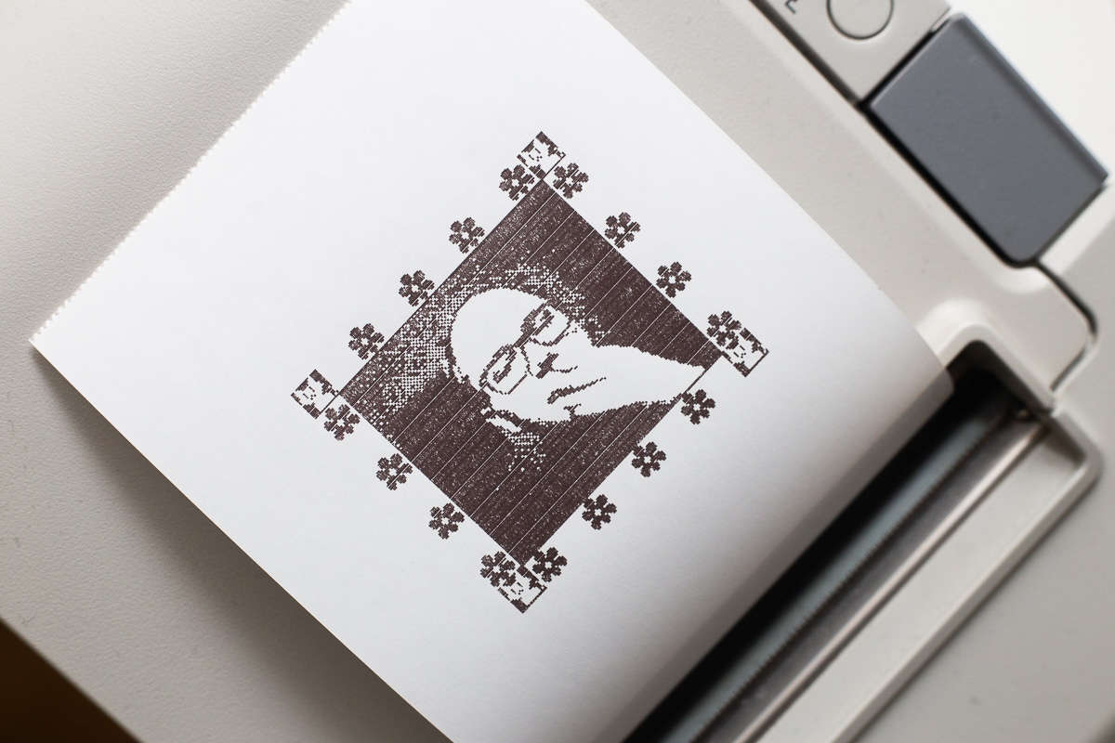
[picture p51: build-instructions/img/gbpxl-build-047.jpg]


&nbsp;

Next, connect your Game Boy and try to print a photo from it.

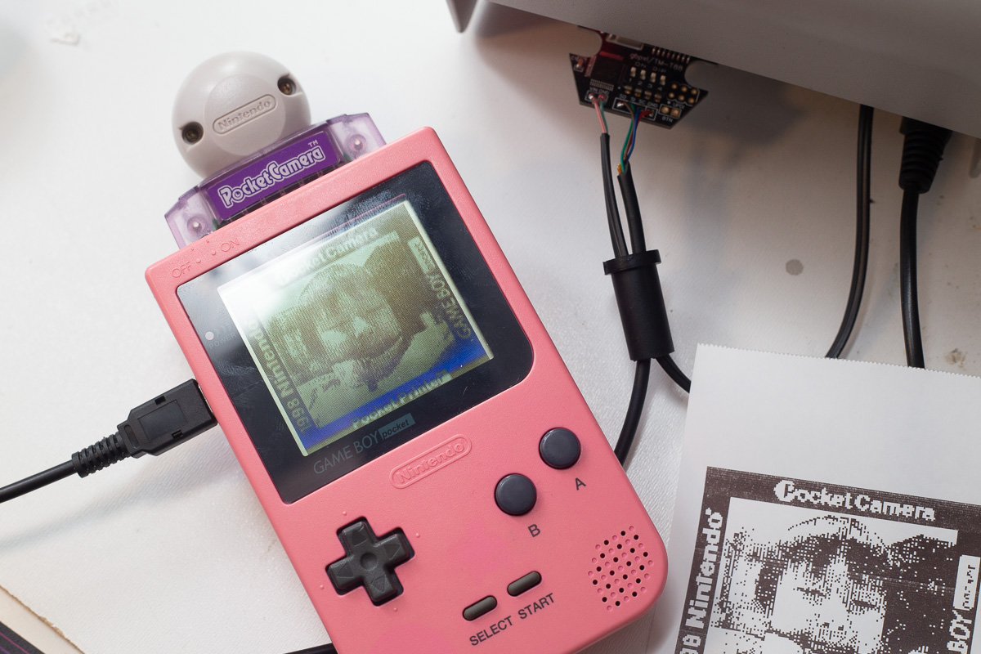
[picture p52: build-instructions/img/gbpxl-build-048.jpg]


## 9. Step: Finishing touches

Use hot glue to secure the cables inside the cable relief.

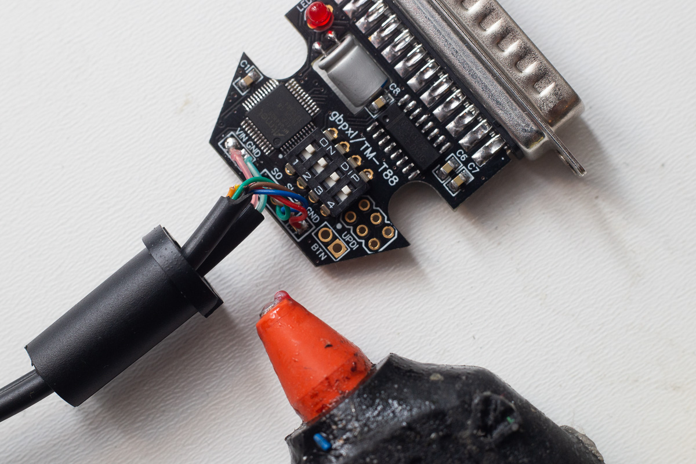
[picture p53: build-instructions/img/gbpxl-build-049.jpg]


&nbsp;

I used red hot glue, but any hot glue should work the same...

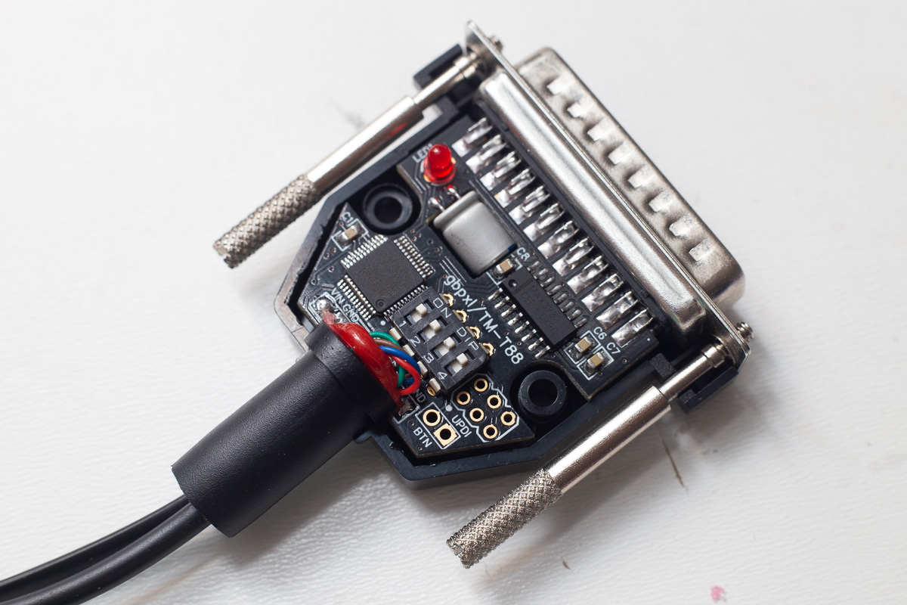
[picture p54: build-instructions/img/gbpxl-build-050.jpg]


&nbsp;

Screw everything together.

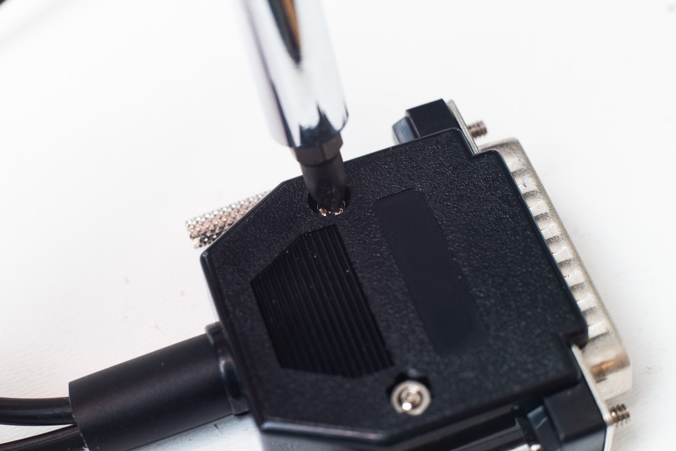
[picture p55: build-instructions/img/gbpxl-build-051.jpg]


## 10. Step: Enjoy!

Don't forget to share your results on your favorite social network using #gbpxl tag!

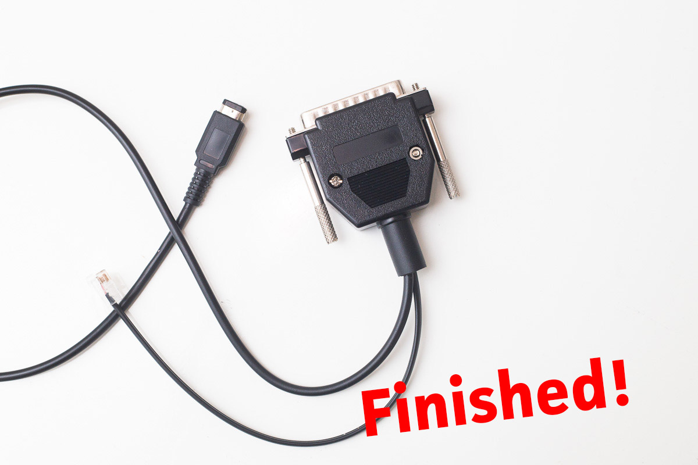
[picture p56: build-instructions/img/gbpxl-build-052.jpg]
