xx0x/gbpxl/(threads)

Thread 1 (2020-11-27):

Update the emulator to v2

CustardFlan, 2020-11-27:
Hi!

Your project it's amazing! I adapted some parts to make it work for cheap Bluetooth thermal printers using a ESP32 (its uploaded to my git), but, i noticed that you are using code from the v1 of Bryan's emulator, so, the printing from the GB it's slow
Do you have any plans to update your code?
Greets from Mexico!

xx0x, 2020-11-27:
Hi! Thanks for the info, I didn't know that V2 was released! I will definitely look into it, but I don't know when...
