xx0x/gbpxl/schematic-bom-pcb/gbpxl-breadboard-nano-every.pdf

# at the cable end

# gbpxl wiring scheme

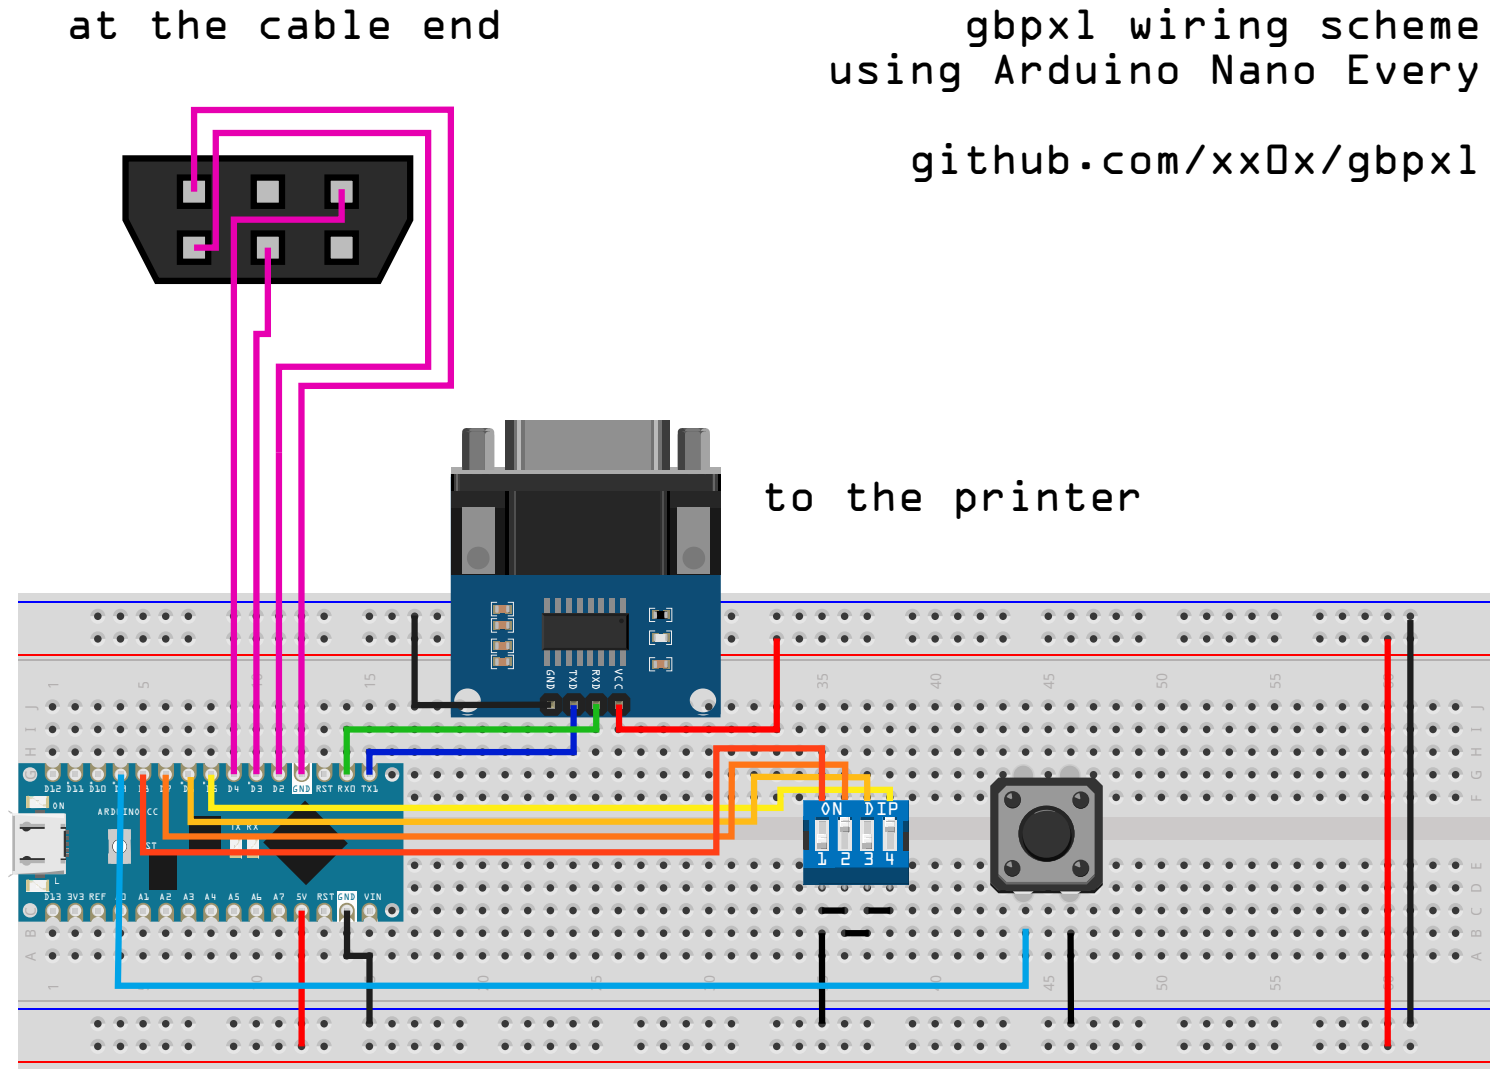
[picture p57: page 1]

using Arduino Nano Every
github.com/xx0x/gbpxl

D13 3V3 REF A0 A1 A2 A3 A4 A5 A6 A7 5V RST GND VIN
