xx0x/gbpxl/schematic-bom-pcb/gbpxl-schematic.pdf

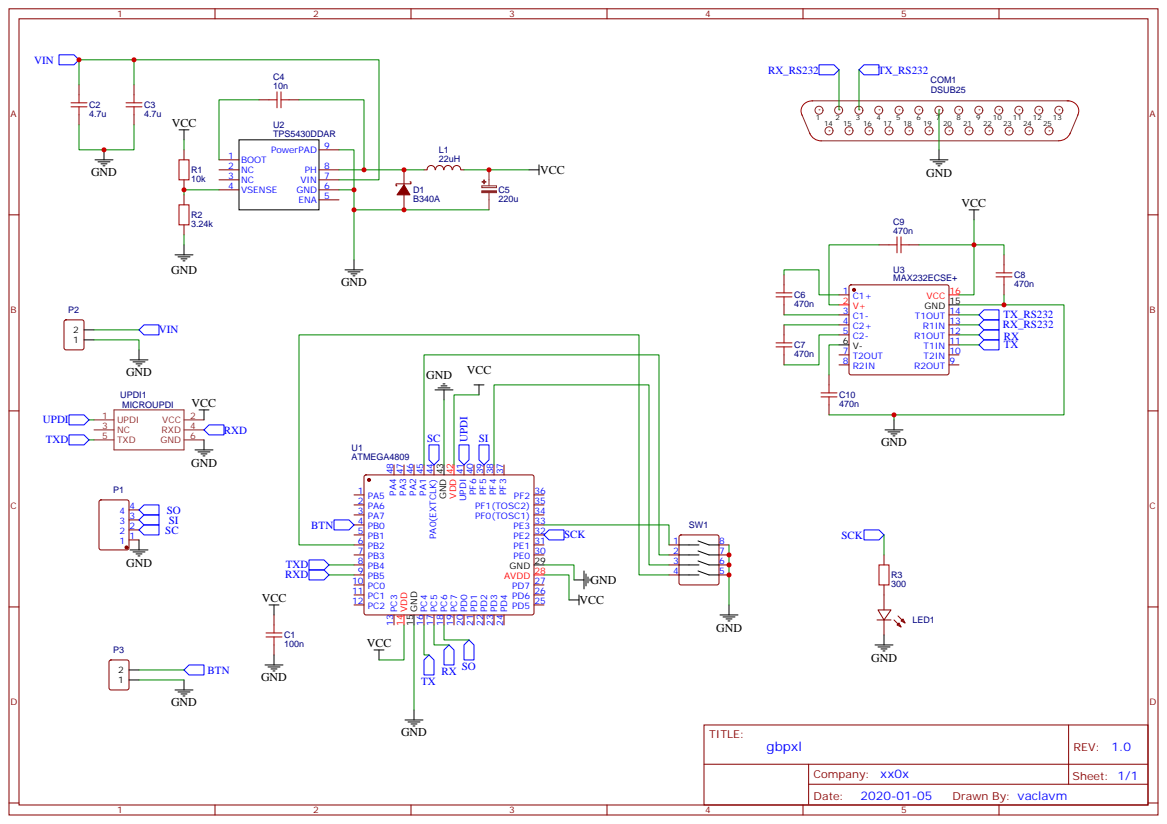
[picture p58: page 1]
