xx0x/gbpxl/(list of files, drawings)

Other design files:
schematic-bom-pcb/gbpxl-pcb-easyeda.json
schematic-bom-pcb/gbpxl-schematic-easyeda.json
