xx0x/gbpxl/test_image_custom_frame.h

const byte testImage[] = {
    0xDF, 0xEF, 0x00, 0x00, 0x03, 0x80, 0x00, 0x00, 0x03, 0x80, 0x00, 0x00, 0x03, 0x80, 0x00, 0x00,
    0x03, 0x80, 0xDF, 0xEF, 0xCF, 0xCF, 0x00, 0x00, 0x07, 0xC0, 0x00, 0x00, 0x07, 0xC0, 0x00, 0x00,
    0x07, 0xC0, 0x00, 0x00, 0x07, 0xC0, 0xCF, 0xCF, 0xC7, 0x8F, 0x00, 0x00, 0x07, 0xC0, 0x00, 0x00,
    0x07, 0xC0, 0x00, 0x00, 0x07, 0xC0, 0x00, 0x00, 0x07, 0xC0, 0xC7, 0x8F, 0xC0, 0x0F, 0x00, 0x00,
    0x37, 0xDC, 0x00, 0x00, 0x37, 0xDC, 0x00, 0x00, 0x37, 0xDC, 0x00, 0x00, 0x37, 0xDC, 0xC0, 0x0F,
    0xC8, 0x8F, 0x00, 0x00, 0x7B, 0xBE, 0x00, 0x00, 0x7B, 0xBE, 0x00, 0x00, 0x7B, 0xBE, 0x00, 0x00,
    0x7B, 0xBE, 0xC8, 0x8F, 0x88, 0x87, 0x00, 0x00, 0x7F, 0xFE, 0x00, 0x00, 0x7F, 0xFE, 0x00, 0x00,
    0x7F, 0xFE, 0x00, 0x00, 0x7F, 0xFE, 0x88, 0x87, 0x88, 0x87, 0x00, 0x00, 0x7E, 0xFE, 0x00, 0x00,
    0x7E, 0xFE, 0x00, 0x00, 0x7E, 0xFE, 0x00, 0x00, 0x7E, 0xFE, 0x88, 0x87, 0x02, 0x03, 0x00, 0x00,
    0x3C, 0x7C, 0x00, 0x00, 0x3C, 0x7C, 0x00, 0x00, 0x3C, 0x7C, 0x00, 0x00, 0x3C, 0x7C, 0x02, 0x03,
    0xC5, 0x0F, 0x00, 0x00, 0x0C, 0x60, 0x00, 0x00, 0x0C, 0x60, 0x00, 0x00, 0x0C, 0x60, 0x00, 0x00,
    0x0C, 0x60, 0xC5, 0x0F, 0xE0, 0x1F, 0x00, 0x00, 0x3E, 0xFC, 0x00, 0x00, 0x3E, 0xFC, 0x00, 0x00,
    0x3E, 0xFC, 0x00, 0x00, 0x3E, 0xFC, 0xE0, 0x1F, 0xF8, 0x3D, 0x00, 0x00, 0x7F, 0xFE, 0x00, 0x00,
    0x7F, 0xFE, 0x00, 0x00, 0x7F, 0xFE, 0x00, 0x00, 0x7F, 0xFE, 0xF8, 0x3D, 0xF0, 0x0E, 0x00, 0x00,
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
    0x55, 0xC0, 0x00, 0x7D, 0xDF, 0xFF, 0xFF, 0xFF, 0xFF, 0xFF, 0x99, 0xE6, 0x03, 0x01, 0xFF, 0xFF,
    0xFE, 0xAB, 0xAE, 0xAB, 0xAE, 0x00, 0x00, 0x1F, 0xAF, 0xFF, 0xFF, 0xFF, 0xFF, 0xFF, 0x80, 0xC0,
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
};
