xx0x/gbpxl/(commit log)

2020-01-19 code improvements, add test image with custom frame
2020-02-11 printer test on startup
2020-02-11 printer test on device start
2020-02-12 add ESC * support, DIP switches change
2020-02-22 add schematic, bom, pcb source
    [gbpxl-bom.ods, gbpxl-pcb-easyeda.json]
2020-02-22 add easyeda schematic source
    [gbpxl-schematic-easyeda.json]
2020-02-29 update power cable pinout
2020-03-25 pinout fixes, instructions update
    [gbpxl.ino]
2020-08-22 add gerber file
2020-08-22 readme change (gerber info)
